danilo-perico/RoboFEI-HT_Drawings/README.md

# RoboFEI-HT_Drawings

Humanoid soccer team from FEI University Center (Brazil).

Repository for mechanical and electronics drawings of our robots and of the robots that have inspired the evolution of our own robots (for example: Darwin-OP).
