danilo-perico/RoboFEI-HT_Drawings/Darwin_OP/Dynamics/mp_arm_lower_l.jpg

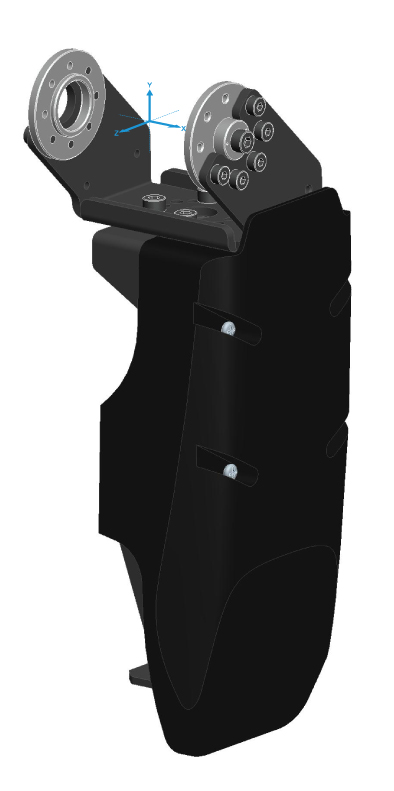
Darwin_OP/Dynamics/mp_arm_lower_l.jpg
