danilo-perico/RoboFEI-HT_Drawings/Darwin_OP/Dynamics/mp_arm_upper_l.jpg

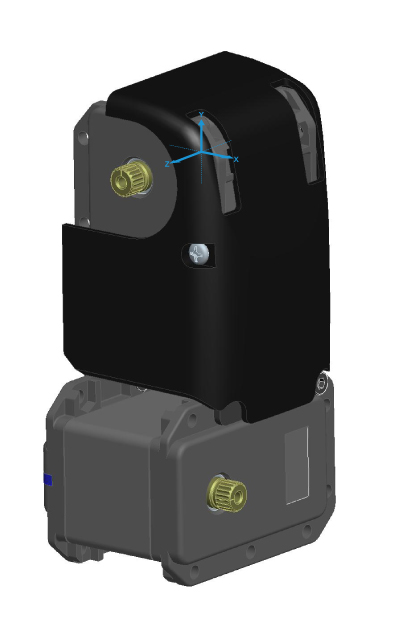
Darwin_OP/Dynamics/mp_arm_upper_l.jpg
