danilo-perico/RoboFEI-HT_Drawings/Darwin_OP/Dynamics/mp_body.jpg

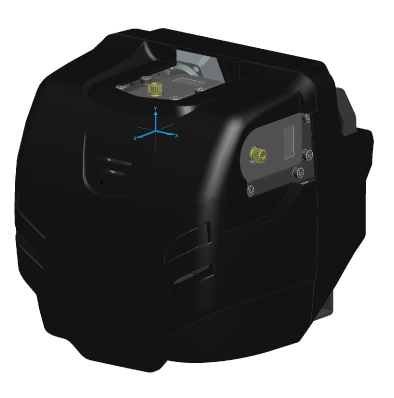
Darwin_OP/Dynamics/mp_body.jpg
