danilo-perico/RoboFEI-HT_Drawings/Darwin_OP/Dynamics/mp_foot_l.jpg

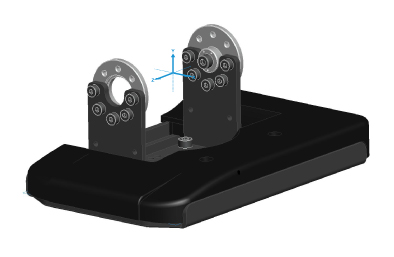
Darwin_OP/Dynamics/mp_foot_l.jpg
