danilo-perico/RoboFEI-HT_Drawings/Darwin_OP/Dynamics/mp_head_1.jpg

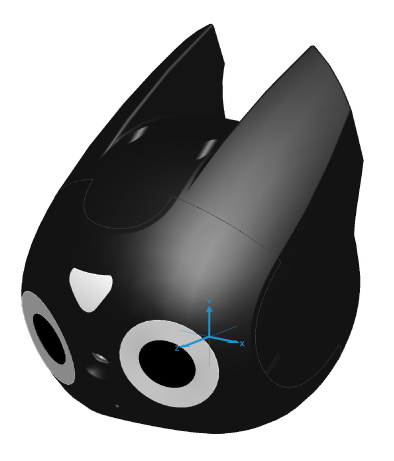
Darwin_OP/Dynamics/mp_head_1.jpg
