danilo-perico/RoboFEI-HT_Drawings/Darwin_OP/Dynamics/mp_head_2.jpg

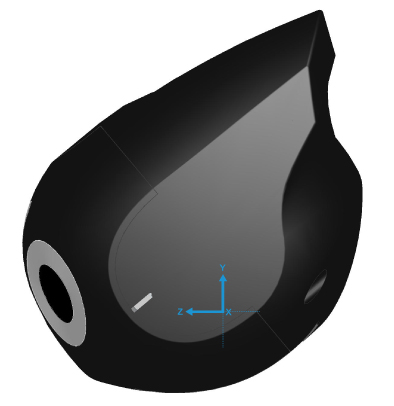
Darwin_OP/Dynamics/mp_head_2.jpg
