danilo-perico/RoboFEI-HT_Drawings/Darwin_OP/Dynamics/mp_neck.jpg

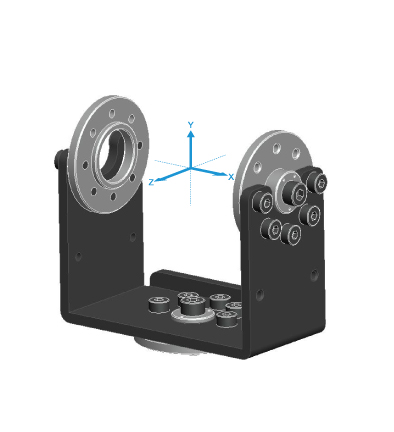
Darwin_OP/Dynamics/mp_neck.jpg
