danilo-perico/RoboFEI-HT_Drawings/Darwin_OP/Dynamics/mp_pelv_y_l.jpg

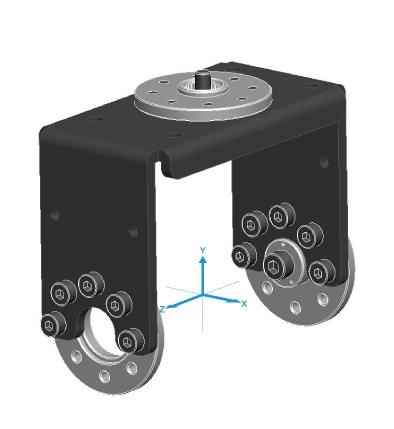
Darwin_OP/Dynamics/mp_pelv_y_l.jpg
