danilo-perico/RoboFEI-HT_Drawings/Milton_robot/Mechanics/DWG CAD/Anexo 1 - Arm0.bmp

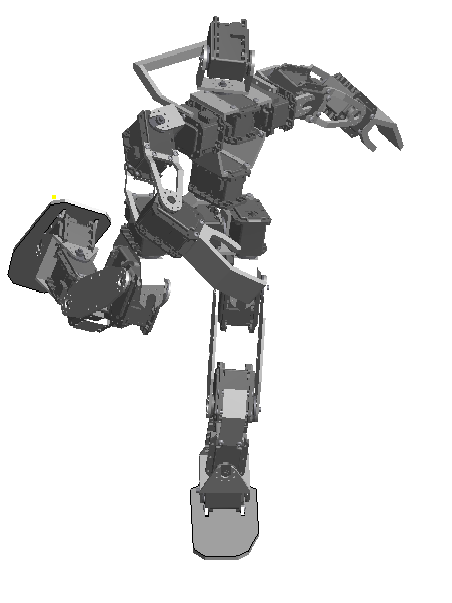
Milton_robot/Mechanics/DWG CAD/Anexo 1 - Arm0.bmp
