danilo-perico/RoboFEI-HT_Drawings/Darwin_OP/Part Files/OP 2D CAD Files/2D STEP/4_PR13_B01_FRM_PCB_MAIN_T.step

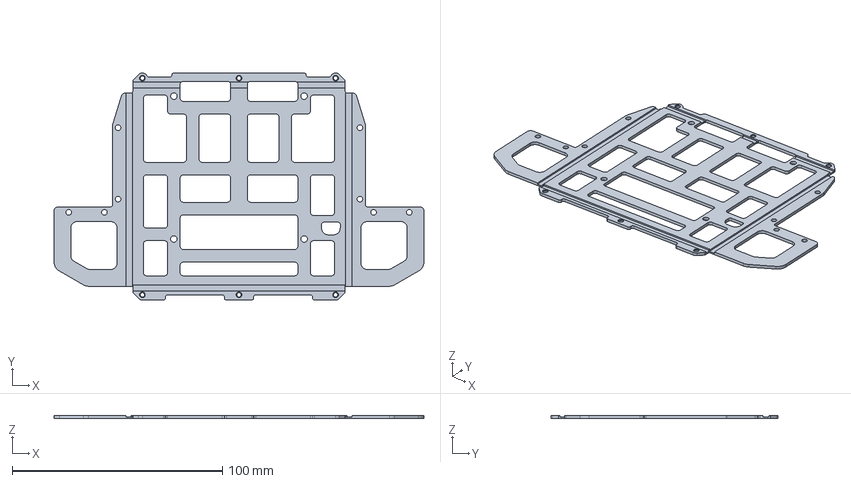
[picture p15: CAD file, 2016-03-04]
Darwin_OP/Part Files/OP 2D CAD Files/2D STEP/4_PR13_B01_FRM_PCB_MAIN_T.step
176.1 x 108.1 x 1.50 mm
