danilo-perico/RoboFEI-HT_Drawings/Darwin_OP/Part Files/OP 3D CAD Files/3D STEP/5_PR13_B01_FRM_PCB_MAIN_B.step

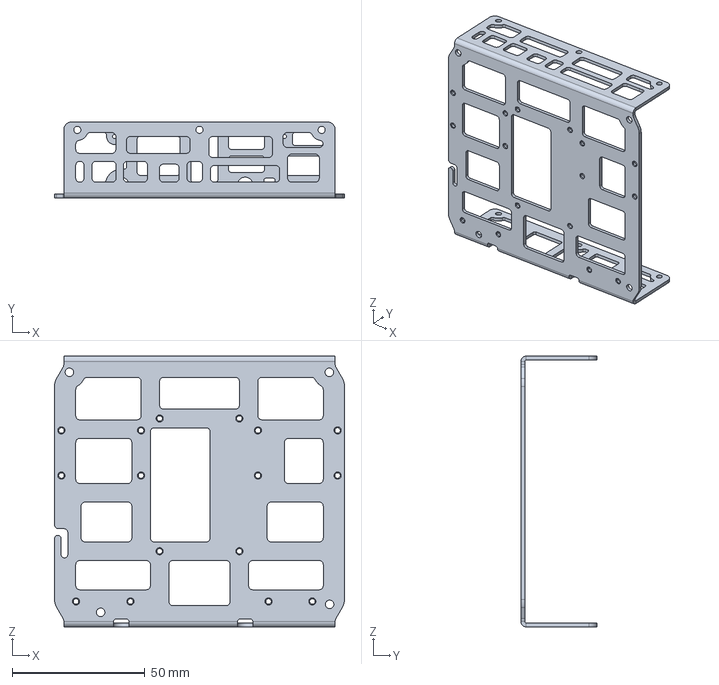
[picture p16: CAD file, 2016-03-04]
Darwin_OP/Part Files/OP 3D CAD Files/3D STEP/5_PR13_B01_FRM_PCB_MAIN_B.step
109.2 x 28.7 x 102.0 mm
