danilo-perico/RoboFEI-HT_Drawings/Darwin_OP/Part Files/OP 2D CAD Files/2D STEP/5_PR13_B01_FRM_PCB_MAIN_B.step

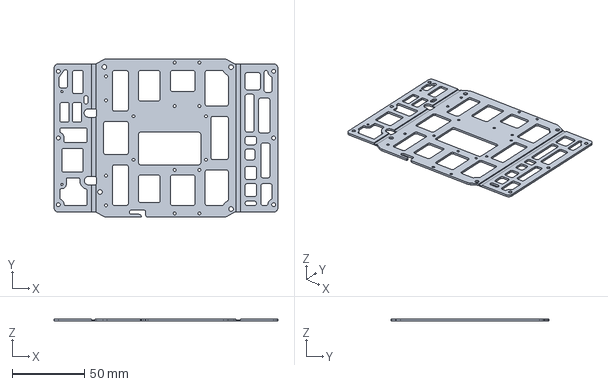
[picture p17: CAD file, 2016-03-04]
Darwin_OP/Part Files/OP 2D CAD Files/2D STEP/5_PR13_B01_FRM_PCB_MAIN_B.step
154.5 x 109.2 x 1.50 mm
