danilo-perico/RoboFEI-HT_Drawings/Darwin_OP/Part Files/OP 3D CAD Files/3D STEP/4_PR13_B01_FRM_PCB_MAIN_T.step

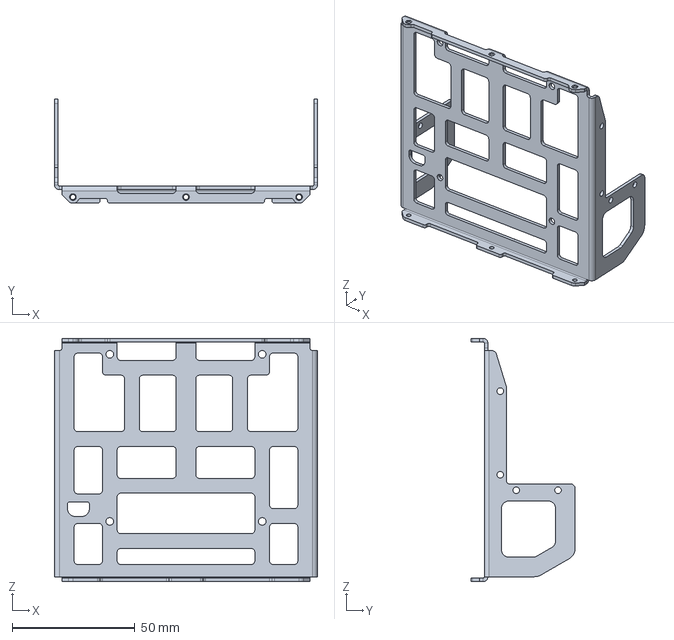
[picture p18: CAD file, 2016-03-04]
Darwin_OP/Part Files/OP 3D CAD Files/3D STEP/4_PR13_B01_FRM_PCB_MAIN_T.step
107.0 x 42.5 x 99.0 mm
