danilo-perico/RoboFEI-HT_Drawings/Darwin_OP/Part Files/OP 3D CAD Files/3D STEP/10_FR07_H102.step

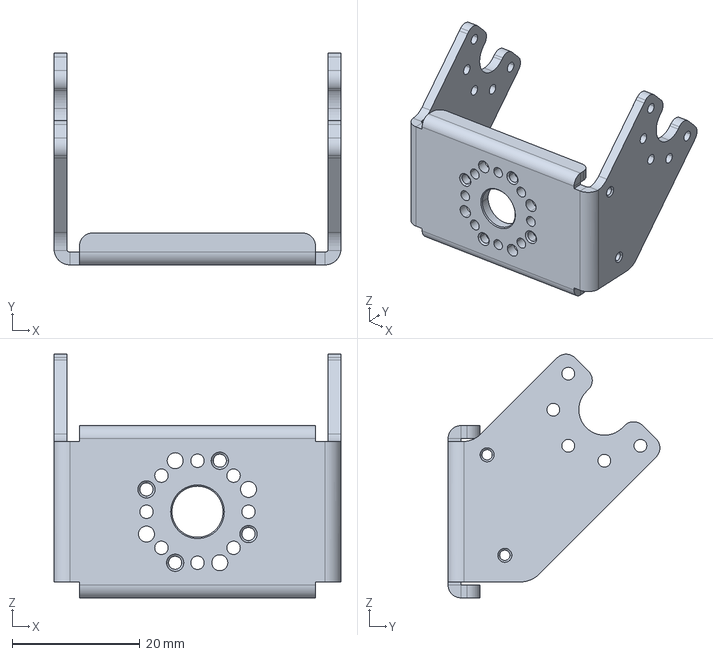
[picture p19: CAD file, 2016-03-04]
Darwin_OP/Part Files/OP 3D CAD Files/3D STEP/10_FR07_H102.step
45.0 x 33.2 x 38.2 mm
