danilo-perico/RoboFEI-HT_Drawings/Darwin_OP/Skin_STP/DARWIN-OP_cvr_eye_l_prt.stp

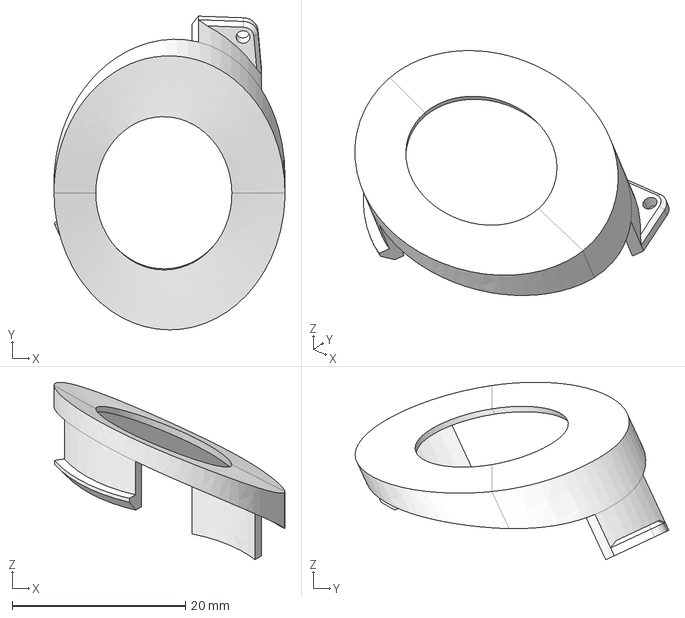
[picture p20: CAD file, 2016-03-04]
Darwin_OP/Skin_STP/DARWIN-OP_cvr_eye_l_prt.stp
26.7 x 36.3 x 20.5 mm
