danilo-perico/RoboFEI-HT_Drawings/FEI/Mesmo Solido/fei.step

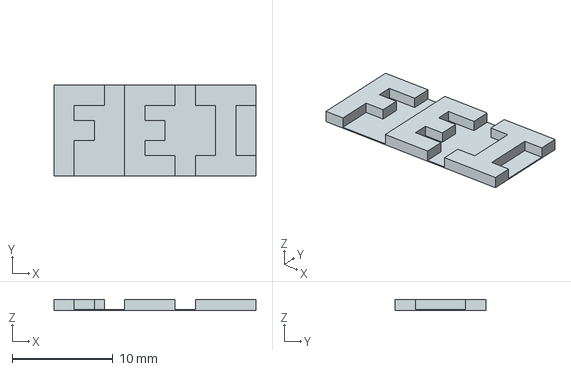
[picture p21: CAD file, 2016-03-04]
FEI/Mesmo Solido/fei.step
20.0 x 9.00 x 1.10 mm
