danilo-perico/RoboFEI-HT_Drawings/FEI/Sem Base/fei.stp

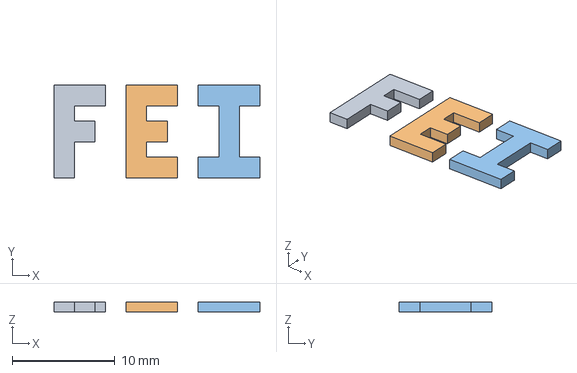
[picture p22: CAD file, 2016-03-04]
FEI/Sem Base/fei.stp
20.0 x 9.00 x 1.00 mm
