danilo-perico/RoboFEI-HT_Drawings/FEI/Solido Diferente/fei.step

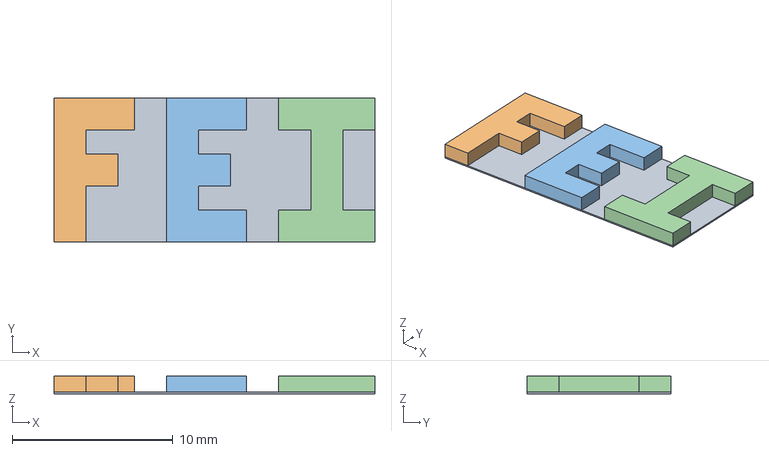
[picture p23: CAD file, 2016-03-04]
FEI/Solido Diferente/fei.step
20.0 x 9.00 x 1.10 mm
