danilo-perico/RoboFEI-HT_Drawings/Darwin_OP/Part Files/OP 2D CAD Files/2D STEP/6_PR13_B_SPACER_PELV.step

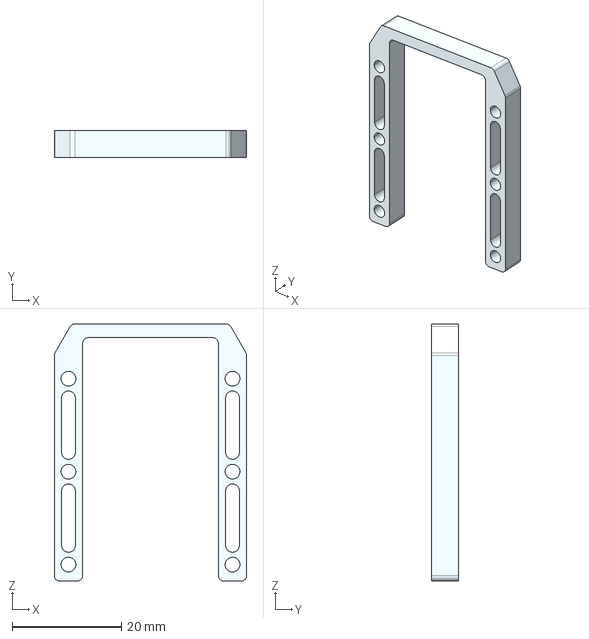
[picture p24: CAD file, 2016-03-04]
Darwin_OP/Part Files/OP 2D CAD Files/2D STEP/6_PR13_B_SPACER_PELV.step
35.2 x 5.00 x 47.0 mm
