danilo-perico/RoboFEI-HT_Drawings/Darwin_OP/Part Files/OP 3D CAD Files/3D STEP/16_FR07_H132.step

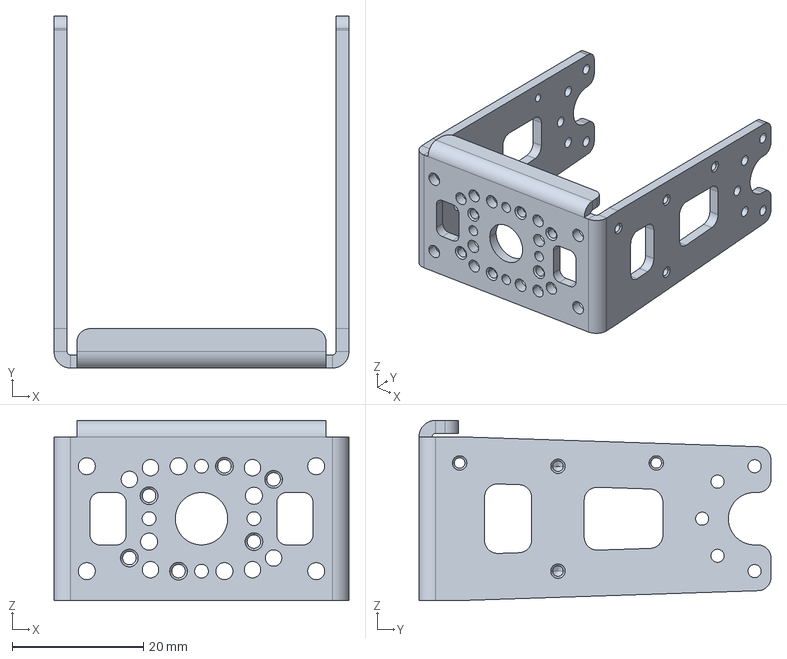
[picture p25: CAD file, 2016-03-04]
Darwin_OP/Part Files/OP 3D CAD Files/3D STEP/16_FR07_H132.step
45.0 x 53.7 x 27.5 mm
