danilo-perico/RoboFEI-HT_Drawings/Darwin_OP/Skin_STP/DARWIN-OP_cvr_foot_l_prt.stp

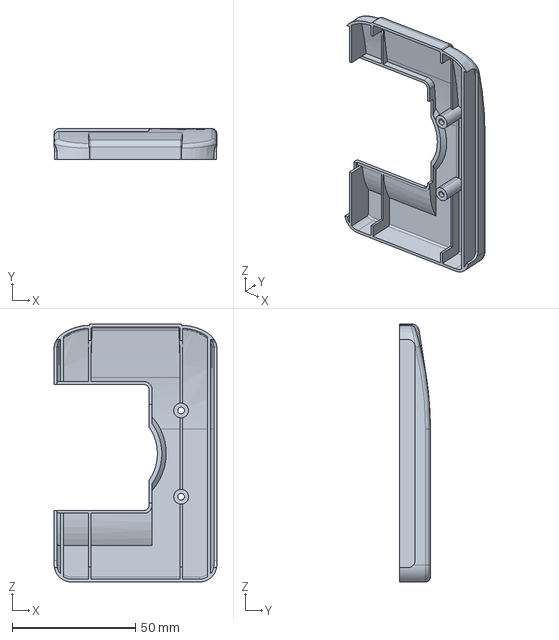
[picture p26: CAD file, 2016-03-04]
Darwin_OP/Skin_STP/DARWIN-OP_cvr_foot_l_prt.stp
66.0 x 12.5 x 104.7 mm
