danilo-perico/RoboFEI-HT_Drawings/Darwin_OP/Part Files/OP 2D CAD Files/2D STEP/9R_PR13_B_BRKT_PELV_R.step

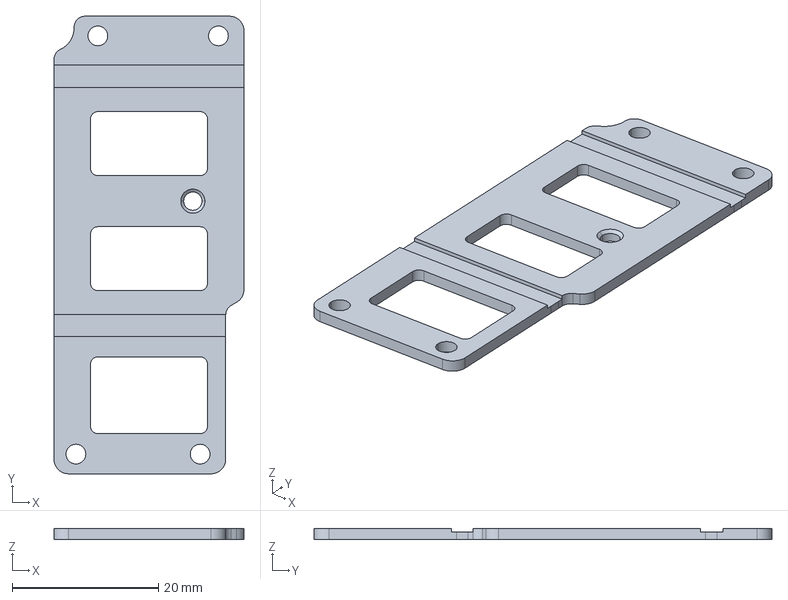
[picture p27: CAD file, 2016-03-04]
Darwin_OP/Part Files/OP 2D CAD Files/2D STEP/9R_PR13_B_BRKT_PELV_R.step
26.0 x 62.6 x 1.50 mm
