danilo-perico/RoboFEI-HT_Drawings/Darwin_OP/Part Files/OP 3D CAD Files/3D STEP/2_FR07_H104.step

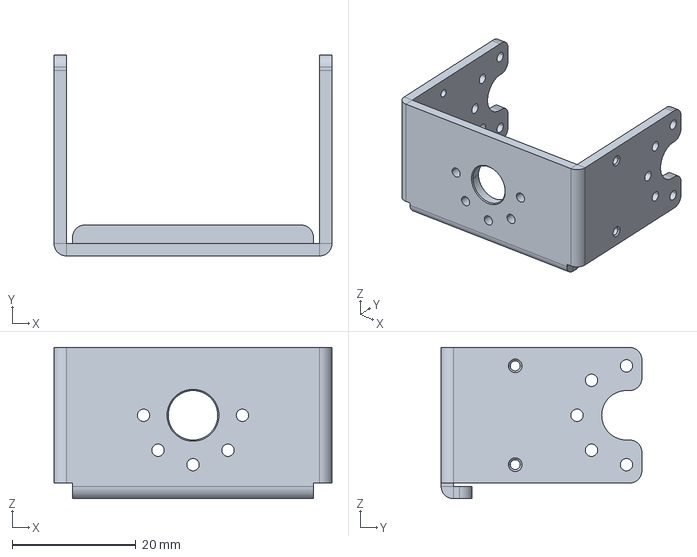
[picture p28: CAD file, 2016-03-04]
Darwin_OP/Part Files/OP 3D CAD Files/3D STEP/2_FR07_H104.step
45.0 x 32.5 x 24.5 mm
