danilo-perico/RoboFEI-HT_Drawings/Darwin_OP/Skin_STP/DARWIN-OP_cvr_head_f_prt.stp

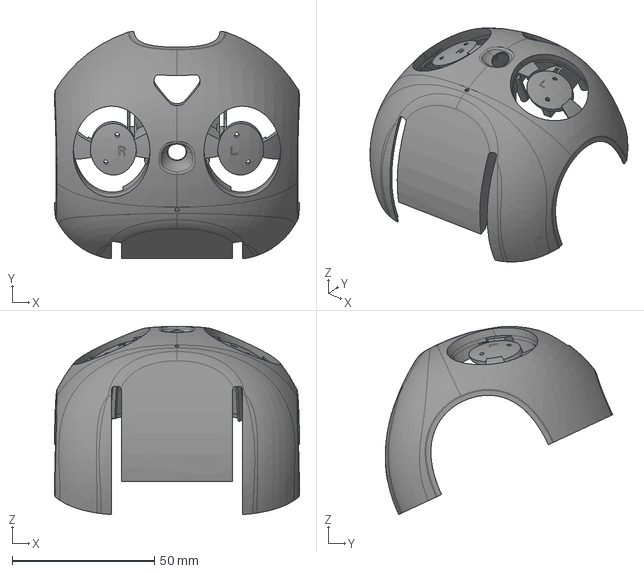
[picture p29: CAD file, 2016-03-04]
Darwin_OP/Skin_STP/DARWIN-OP_cvr_head_f_prt.stp
86.2 x 80.0 x 66.1 mm
