danilo-perico/RoboFEI-HT_Drawings/Darwin_OP/Part Files/OP 2D CAD Files/2D STEP/1_PR13_B01_BRKT_CAM.step

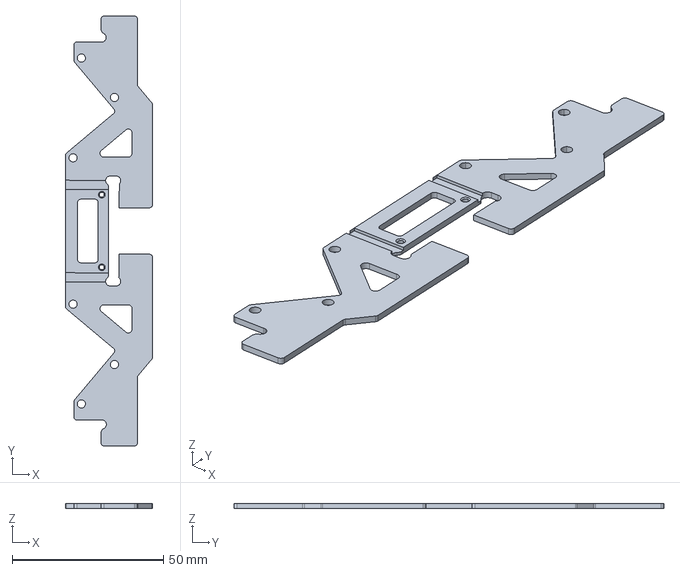
[picture p30: CAD file, 2016-03-04]
Darwin_OP/Part Files/OP 2D CAD Files/2D STEP/1_PR13_B01_BRKT_CAM.step
28.8 x 142.1 x 1.50 mm
