danilo-perico/RoboFEI-HT_Drawings/Darwin_OP/Part Files/OP 3D CAD Files/3D STEP/14_FR07_S101.step

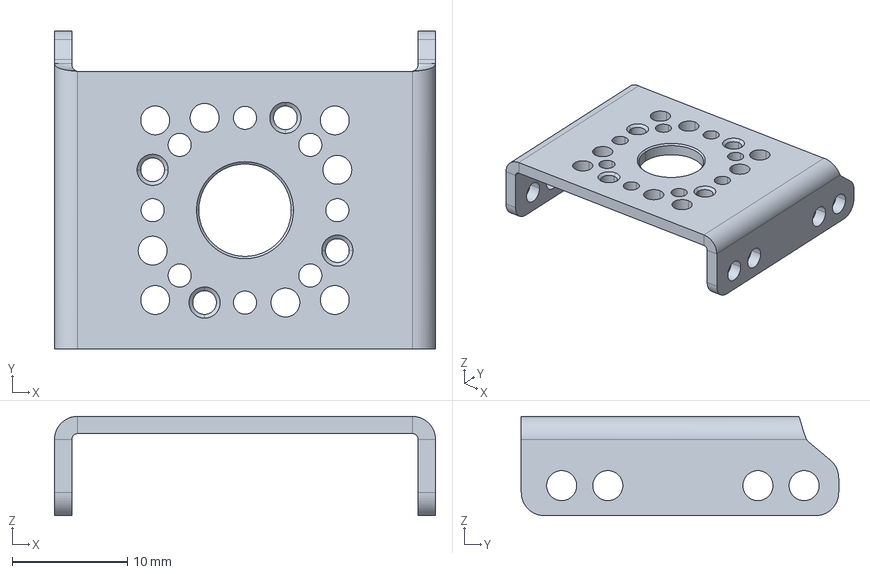
[picture p31: CAD file, 2016-03-04]
Darwin_OP/Part Files/OP 3D CAD Files/3D STEP/14_FR07_S101.step
33.0 x 27.5 x 8.60 mm
