danilo-perico/RoboFEI-HT_Drawings/Darwin_OP/Skin_STP/DARWIN-OP_cvr_body_f_prt.stp

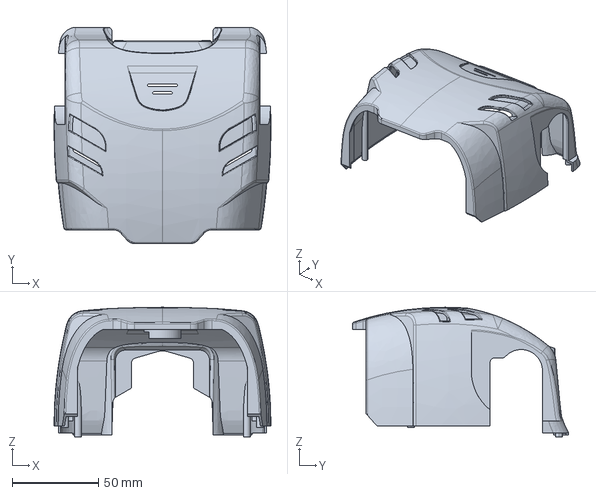
[picture p32: CAD file, 2016-03-04]
Darwin_OP/Skin_STP/DARWIN-OP_cvr_body_f_prt.stp
126.0 x 125.5 x 75.2 mm
