danilo-perico/RoboFEI-HT_Drawings/Darwin_OP/Part Files/OP 2D CAD Files/2D STEP/14_FR07_S101.step

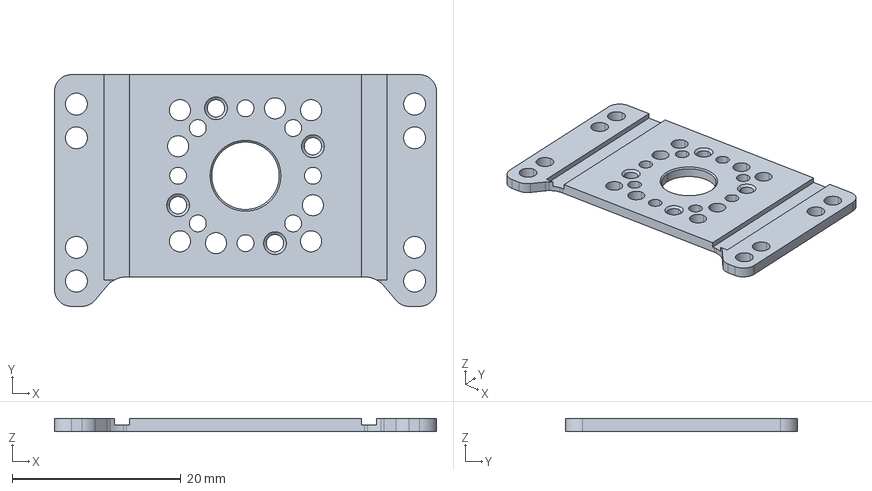
[picture p33: CAD file, 2016-03-04]
Darwin_OP/Part Files/OP 2D CAD Files/2D STEP/14_FR07_S101.step
45.3 x 27.5 x 1.50 mm
