danilo-perico/RoboFEI-HT_Drawings/Darwin_OP/Skin_STP/DARWIN-OP_cvr_pupil_l_prt.stp

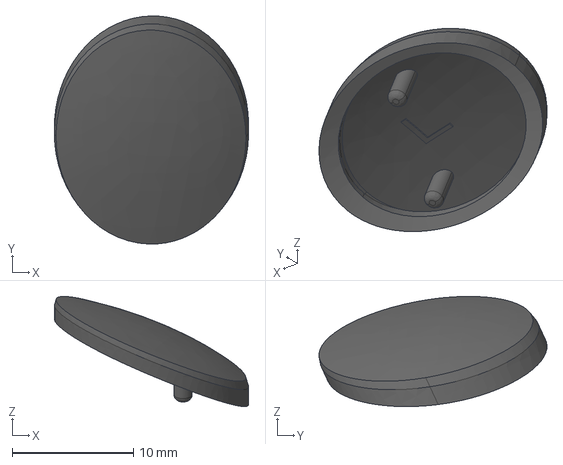
[picture p34: CAD file, 2016-03-04]
Darwin_OP/Skin_STP/DARWIN-OP_cvr_pupil_l_prt.stp
16.0 x 18.8 x 9.08 mm
