danilo-perico/RoboFEI-HT_Drawings/Darwin_OP/Part Files/OP 2D CAD Files/2D STEP/17_FR07_H133.step

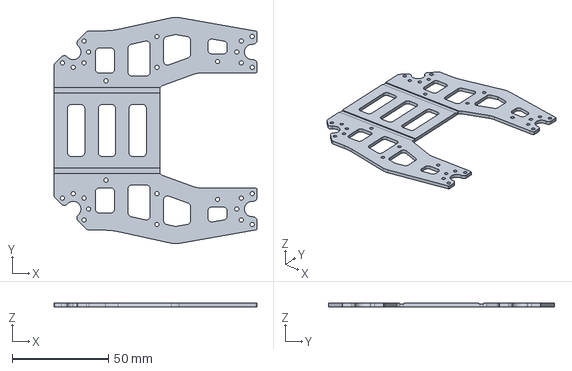
[picture p35: CAD file, 2016-03-04]
Darwin_OP/Part Files/OP 2D CAD Files/2D STEP/17_FR07_H133.step
105.5 x 117.7 x 2.00 mm
