danilo-perico/RoboFEI-HT_Drawings/Darwin_OP/Part Files/OP 3D CAD Files/3D STEP/17_FR07_H133.step

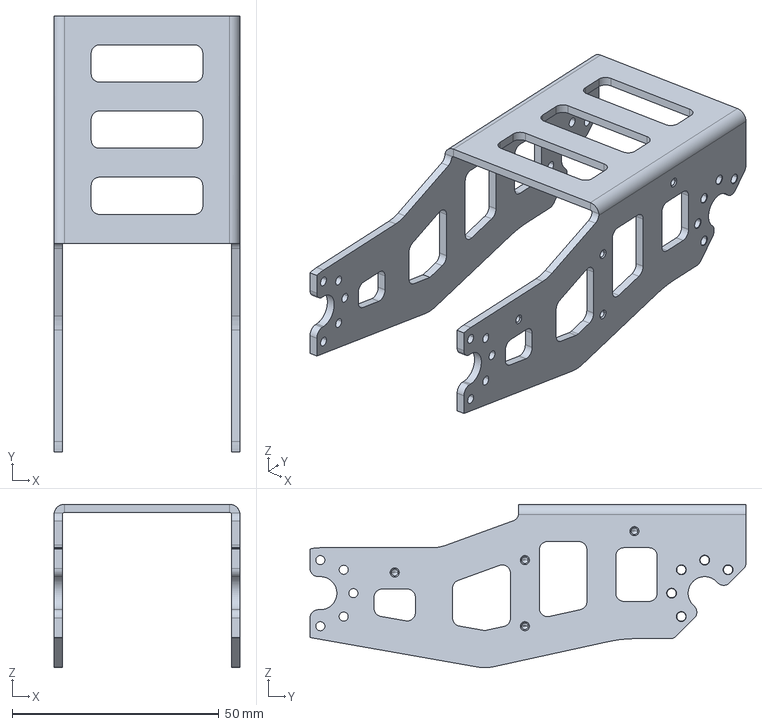
[picture p36: CAD file, 2016-03-04]
Darwin_OP/Part Files/OP 3D CAD Files/3D STEP/17_FR07_H133.step
45.0 x 105.5 x 39.5 mm
