danilo-perico/RoboFEI-HT_Drawings/Darwin_OP/Skin_STP/DARWIN-OP_cvr_arm_u_prt.stp

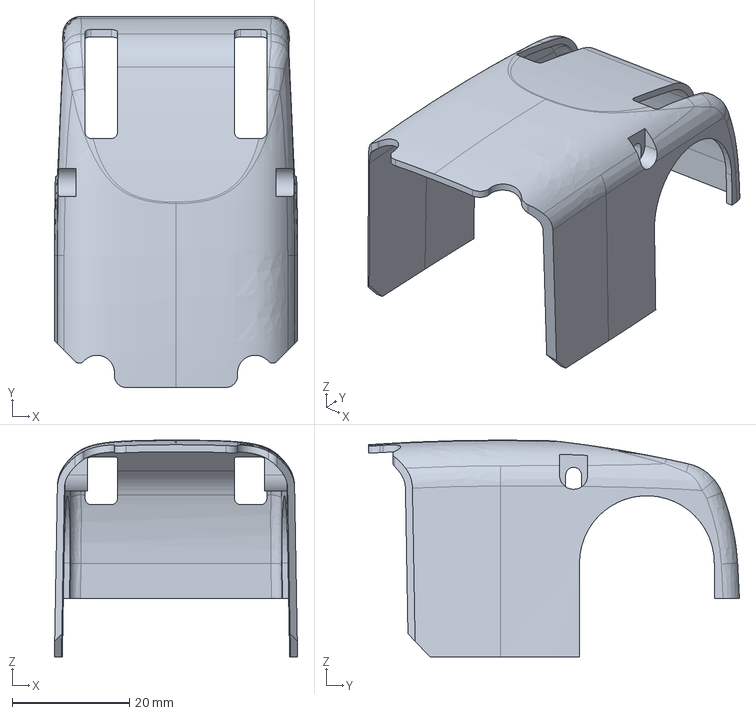
[picture p37: CAD file, 2016-03-04]
Darwin_OP/Skin_STP/DARWIN-OP_cvr_arm_u_prt.stp
41.5 x 63.3 x 37.0 mm
