danilo-perico/RoboFEI-HT_Drawings/Darwin_OP/Part Files/OP 2D CAD Files/2D STEP/7_FR07_E130.step

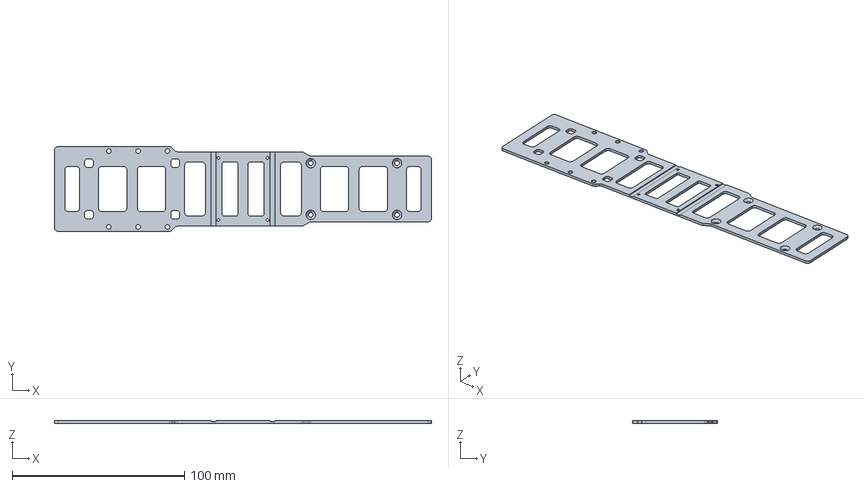
[picture p38: CAD file, 2016-03-04]
Darwin_OP/Part Files/OP 2D CAD Files/2D STEP/7_FR07_E130.step
218.6 x 49.2 x 1.50 mm
