danilo-perico/RoboFEI-HT_Drawings/Darwin_OP/Part Files/OP 3D CAD Files/3D STEP/7_FR07_E130.step

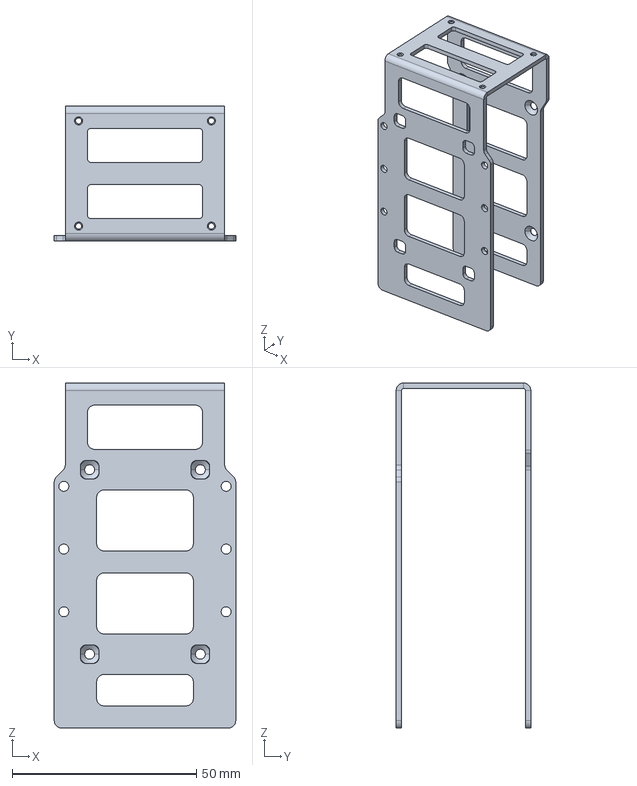
[picture p39: CAD file, 2016-03-04]
Darwin_OP/Part Files/OP 3D CAD Files/3D STEP/7_FR07_E130.step
49.2 x 36.5 x 93.5 mm
