danilo-perico/RoboFEI-HT_Drawings/Darwin_OP/Skin_STP/DARWIN-OP_cvr_body_b_prt.stp

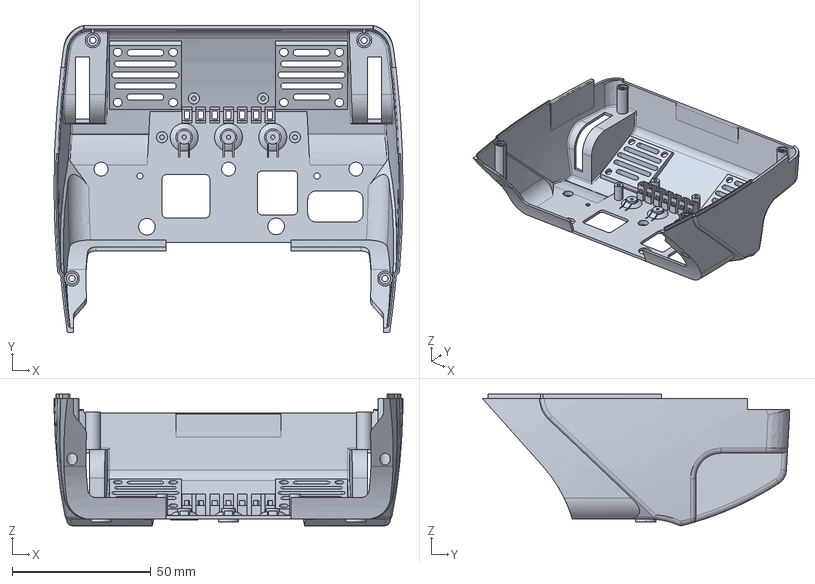
[picture p40: CAD file, 2016-03-04]
Darwin_OP/Skin_STP/DARWIN-OP_cvr_body_b_prt.stp
126.0 x 111.0 x 47.5 mm
