danilo-perico/RoboFEI-HT_Drawings/Darwin_OP/Part Files/OP 2D CAD Files/2D STEP/3_FR07_X101.step

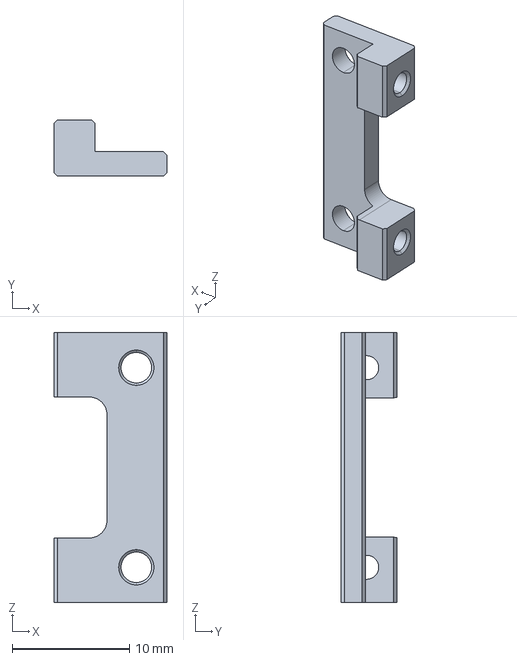
[picture p41: CAD file, 2016-03-04]
Darwin_OP/Part Files/OP 2D CAD Files/2D STEP/3_FR07_X101.step
9.60 x 4.80 x 23.0 mm
