danilo-perico/RoboFEI-HT_Drawings/Darwin_OP/Part Files/OP 3D CAD Files/3D STEP/12_FR07_E180.step

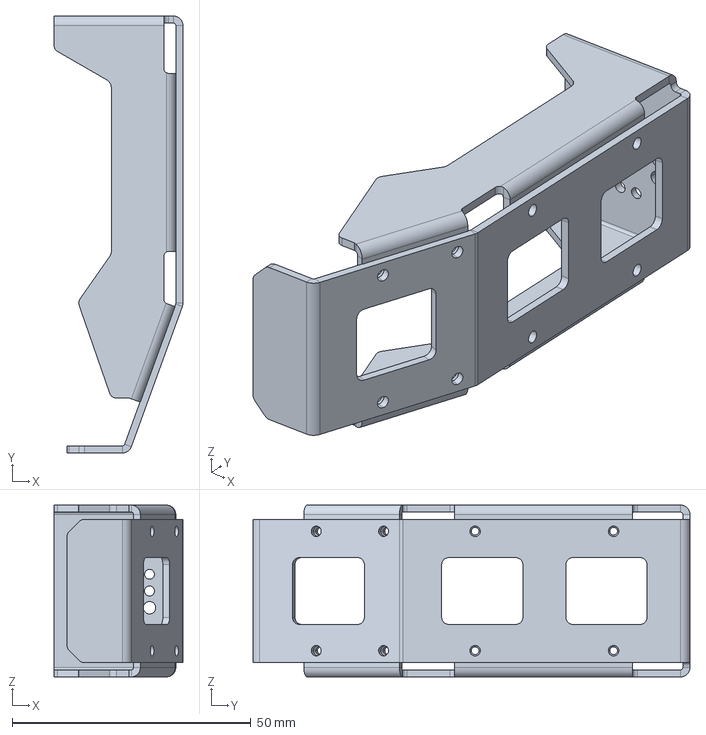
[picture p42: CAD file, 2016-03-04]
Darwin_OP/Part Files/OP 3D CAD Files/3D STEP/12_FR07_E180.step
27.0 x 91.5 x 36.0 mm
