danilo-perico/RoboFEI-HT_Drawings/Darwin_OP/Part Files/OP 2D CAD Files/2D STEP/18_FR07_E160.step

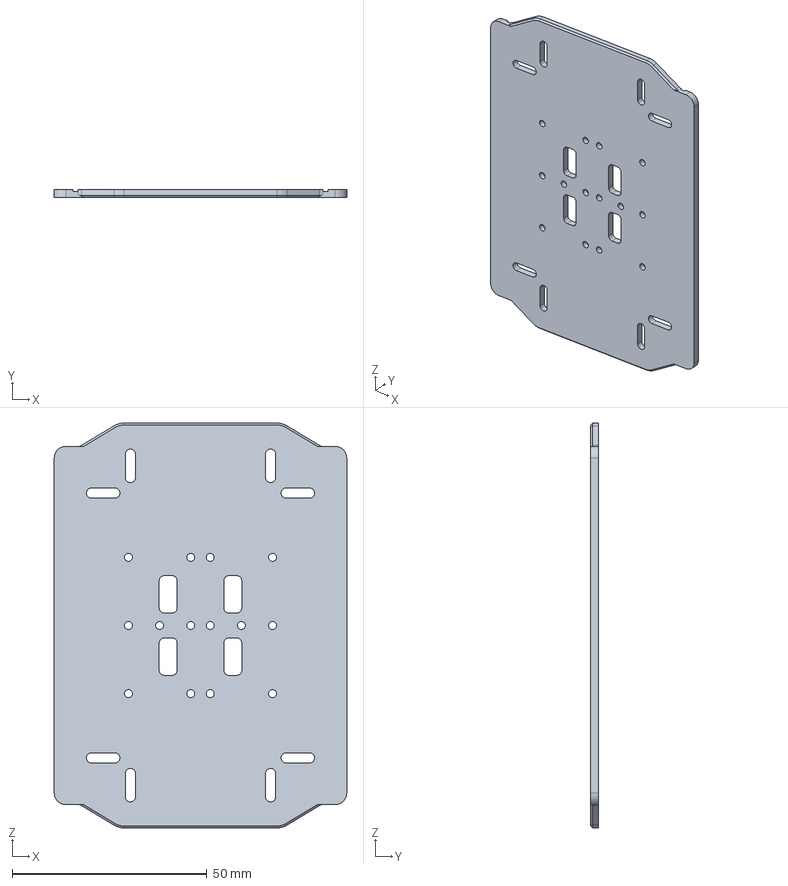
[picture p43: CAD file, 2016-03-04]
Darwin_OP/Part Files/OP 2D CAD Files/2D STEP/18_FR07_E160.step
75.1 x 2.00 x 104.0 mm
