danilo-perico/RoboFEI-HT_Drawings/Darwin_OP/Part Files/OP 3D CAD Files/3D STEP/1_PR13_B01_BRKT_CAM.step

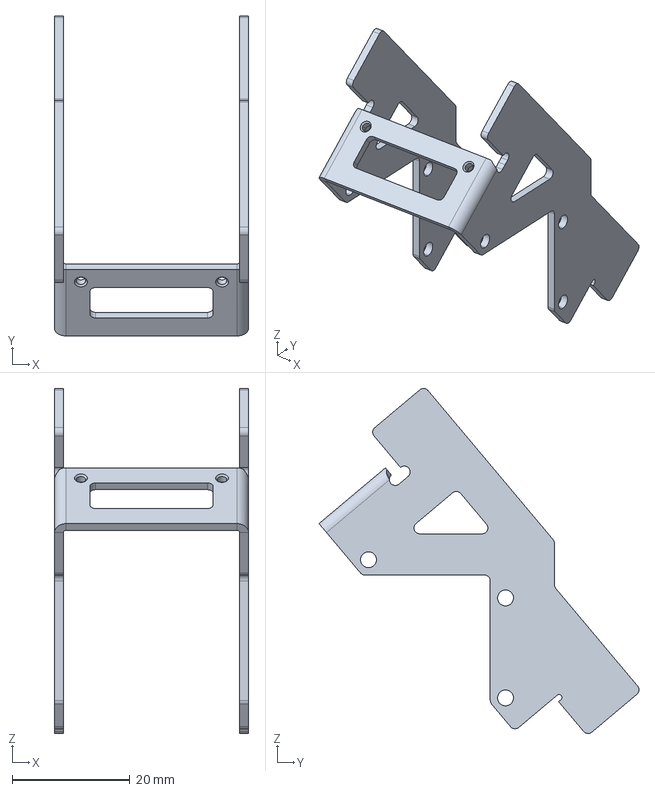
[picture p44: CAD file, 2016-03-04]
Darwin_OP/Part Files/OP 3D CAD Files/3D STEP/1_PR13_B01_BRKT_CAM.step
33.0 x 54.4 x 58.7 mm
