danilo-perico/RoboFEI-HT_Drawings/Darwin_OP/Skin_STP/DARWIN-OP_cvr_thigh_prt.stp

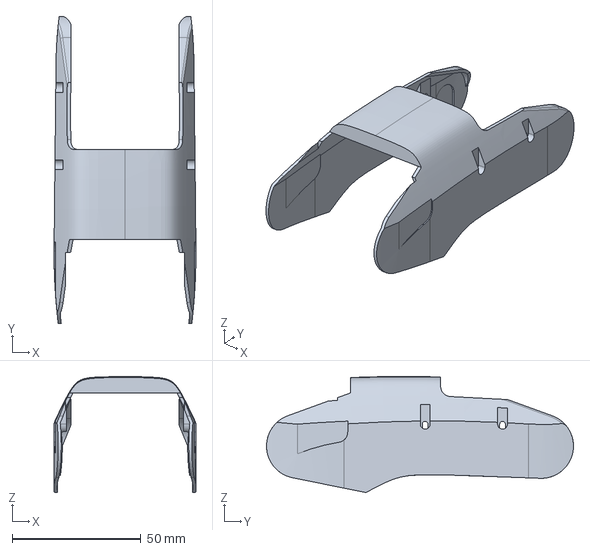
[picture p45: CAD file, 2016-03-04]
Darwin_OP/Skin_STP/DARWIN-OP_cvr_thigh_prt.stp
55.0 x 119.0 x 45.0 mm
