danilo-perico/RoboFEI-HT_Drawings/Darwin_OP/Part Files/OP 2D CAD Files/2D STEP/11_FR07_SC101.step

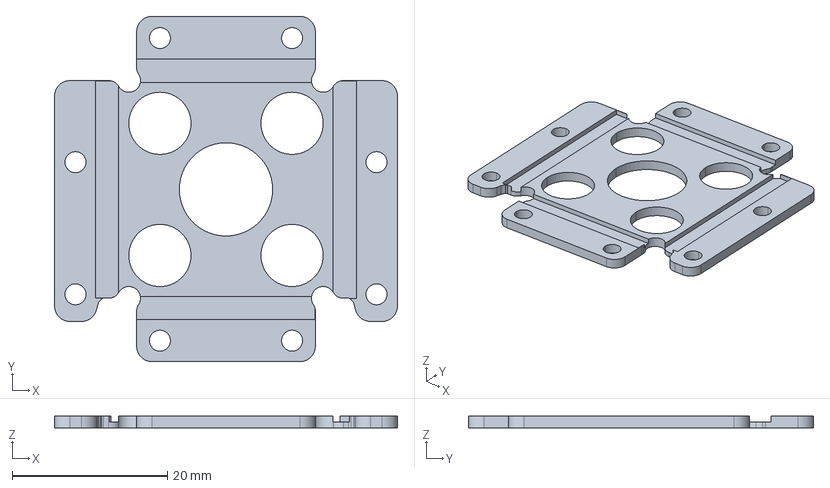
[picture p46: CAD file, 2016-03-04]
Darwin_OP/Part Files/OP 2D CAD Files/2D STEP/11_FR07_SC101.step
44.1 x 44.4 x 1.50 mm
