danilo-perico/RoboFEI-HT_Drawings/Darwin_OP/Part Files/OP 3D CAD Files/3D STEP/8_PR13_FRM_CVR_BAT.step

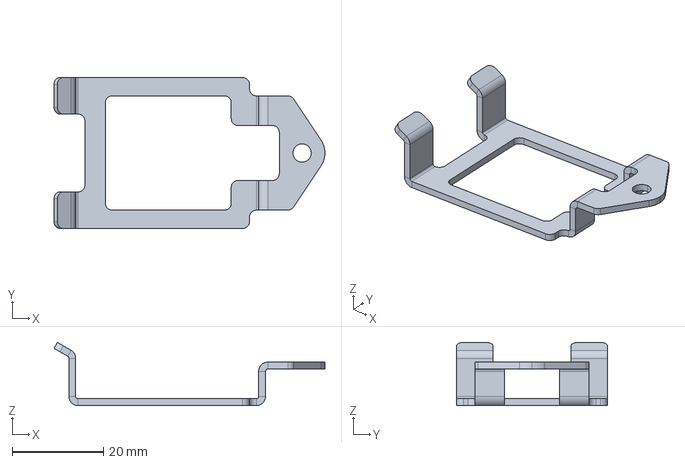
[picture p47: CAD file, 2016-03-04]
Darwin_OP/Part Files/OP 3D CAD Files/3D STEP/8_PR13_FRM_CVR_BAT.step
59.2 x 33.0 x 13.8 mm
