danilo-perico/RoboFEI-HT_Drawings/Darwin_OP/Skin_STP/DARWIN-OP_cvr_head_b_prt.stp

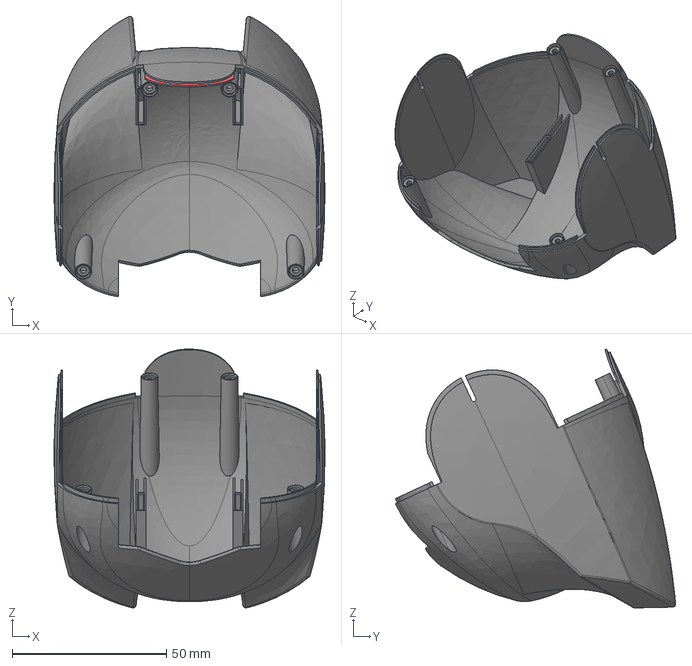
[picture p48: CAD file, 2016-03-04]
Darwin_OP/Skin_STP/DARWIN-OP_cvr_head_b_prt.stp
88.0 x 91.0 x 84.1 mm
