danilo-perico/RoboFEI-HT_Drawings/Darwin_OP/Part Files/OP 2D CAD Files/2D STEP/2_FR07_H104.step

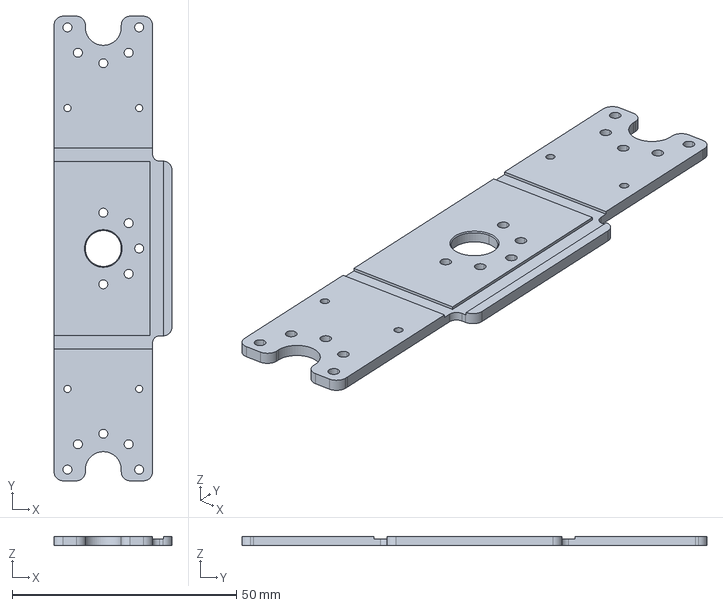
[picture p49: CAD file, 2016-03-04]
Darwin_OP/Part Files/OP 2D CAD Files/2D STEP/2_FR07_H104.step
26.3 x 103.6 x 2.00 mm
