danilo-perico/RoboFEI-HT_Drawings/Darwin_OP/Skin_STP/DARWIN-OP_cvr_arm_l_prt.stp

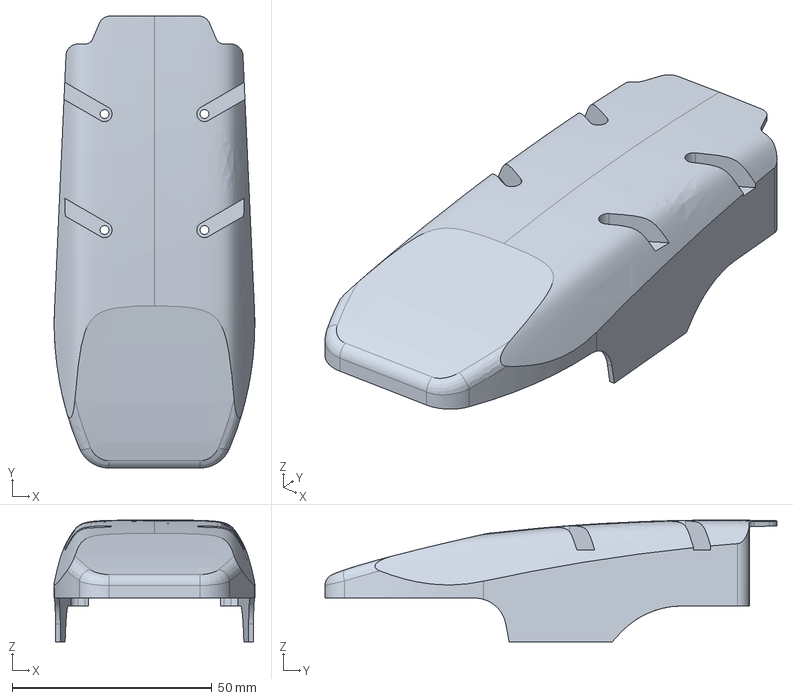
[picture p50: CAD file, 2016-03-04]
Darwin_OP/Skin_STP/DARWIN-OP_cvr_arm_l_prt.stp
50.2 x 113.0 x 30.5 mm
