danilo-perico/RoboFEI-HT_Drawings/Darwin_OP/Part Files/OP 2D CAD Files/2D STEP/12_FR07_E180.step

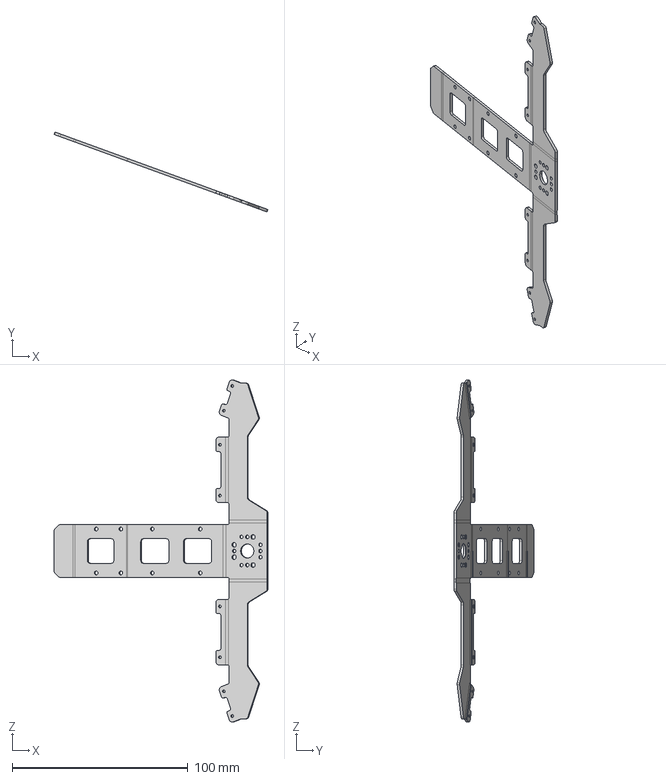
[picture p51: CAD file, 2016-03-04]
Darwin_OP/Part Files/OP 2D CAD Files/2D STEP/12_FR07_E180.step
121.8 x 45.6 x 194.8 mm
