danilo-perico/RoboFEI-HT_Drawings/Darwin_OP/Part Files/OP 3D CAD Files/3D STEP/9R_PR13_B_BRKT_PELV_R.step

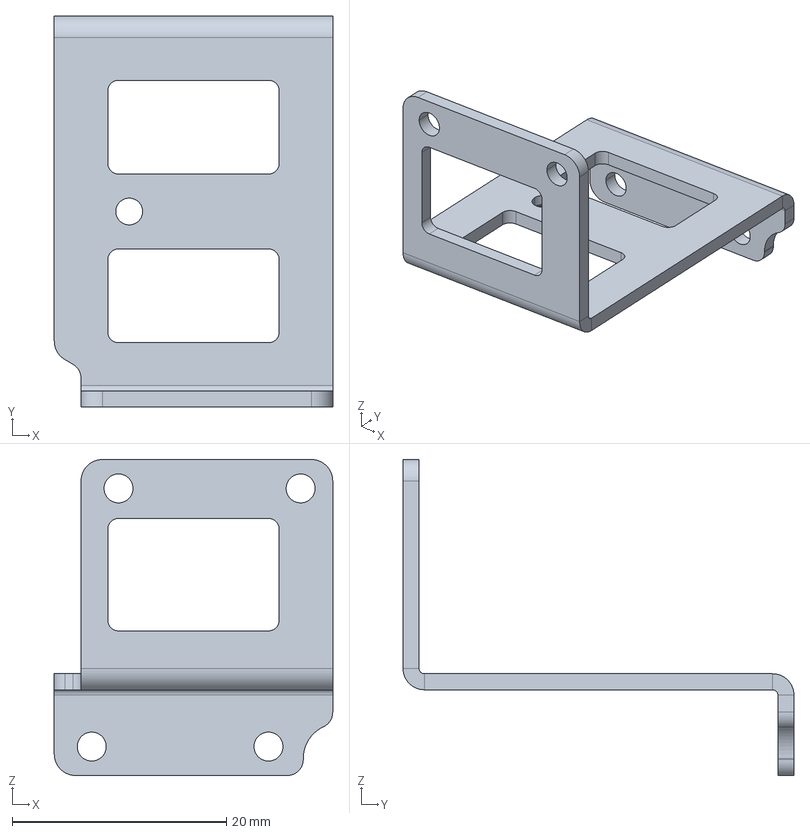
[picture p52: CAD file, 2016-03-04]
Darwin_OP/Part Files/OP 3D CAD Files/3D STEP/9R_PR13_B_BRKT_PELV_R.step
26.0 x 36.5 x 29.5 mm
