danilo-perico/RoboFEI-HT_Drawings/Darwin_OP/Part Files/OP 2D CAD Files/2D STEP/8_PR13_B_FRM_CVR_BAT.step

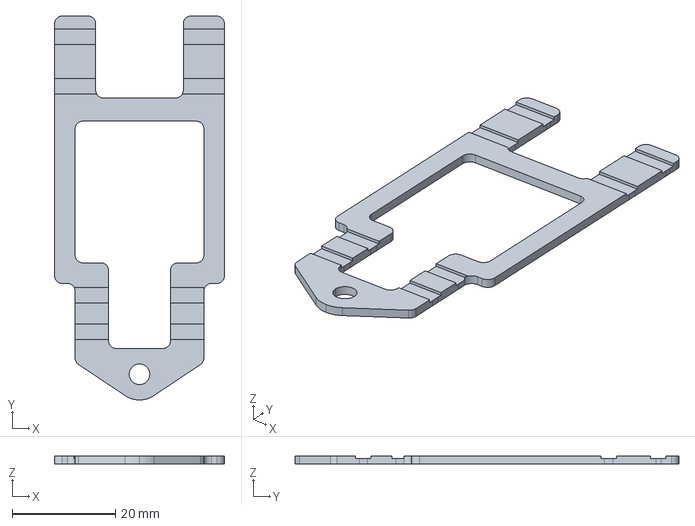
[picture p53: CAD file, 2016-03-04]
Darwin_OP/Part Files/OP 2D CAD Files/2D STEP/8_PR13_B_FRM_CVR_BAT.step
33.0 x 74.5 x 1.50 mm
