danilo-perico/RoboFEI-HT_Drawings/Darwin_OP/Part Files/OP 3D CAD Files/3D STEP/18_FR07_E160.step

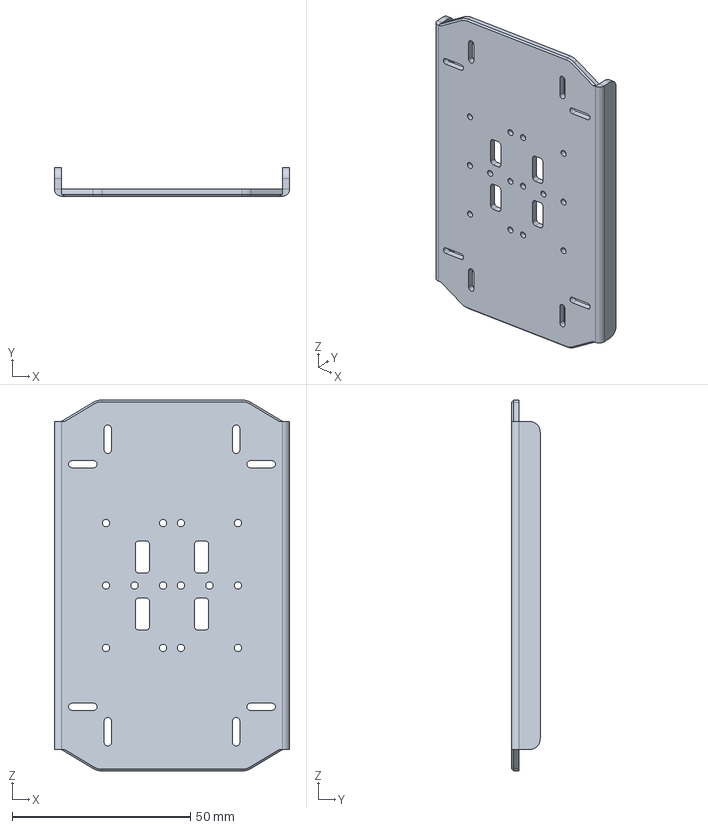
[picture p54: CAD file, 2016-03-04]
Darwin_OP/Part Files/OP 3D CAD Files/3D STEP/18_FR07_E160.step
66.0 x 8.00 x 104.0 mm
