danilo-perico/RoboFEI-HT_Drawings/Darwin_OP/Skin_STP/DARWIN-OP_win_led_prt.stp

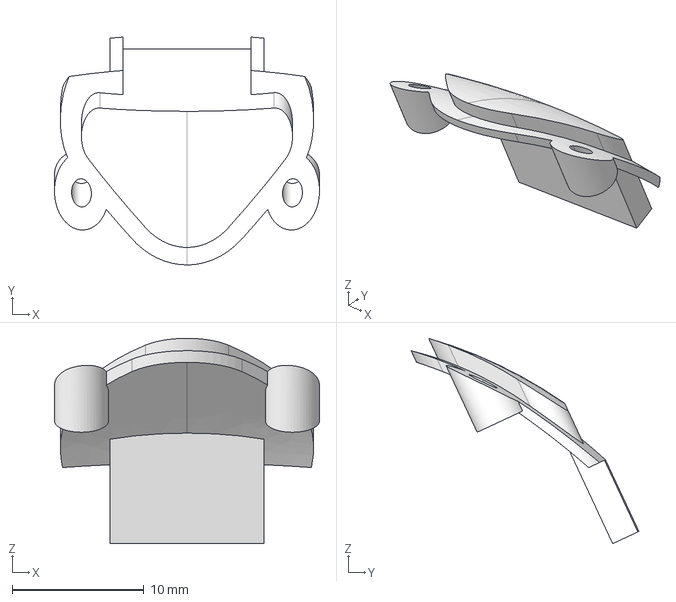
[picture p55: CAD file, 2016-03-04]
Darwin_OP/Skin_STP/DARWIN-OP_win_led_prt.stp
20.1 x 17.3 x 15.6 mm
