danilo-perico/RoboFEI-HT_Drawings/Darwin_OP/Part Files/OP 2D CAD Files/2D STEP/15_FR07_X102.step

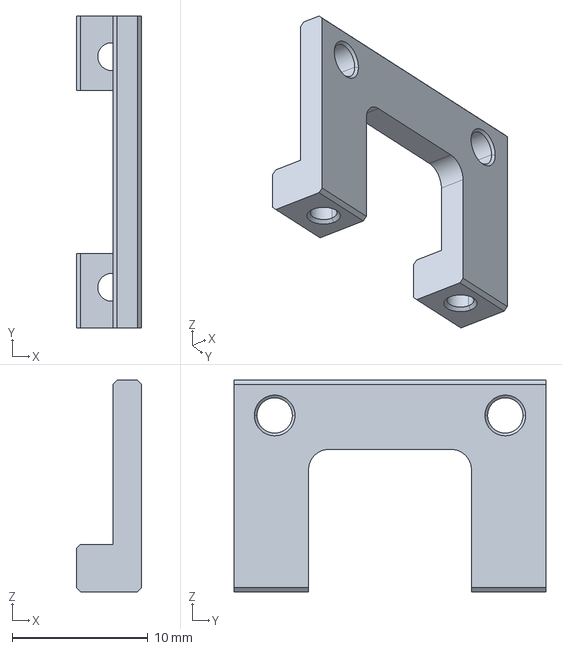
[picture p56: CAD file, 2016-03-04]
Darwin_OP/Part Files/OP 2D CAD Files/2D STEP/15_FR07_X102.step
4.80 x 23.0 x 15.6 mm
