danilo-perico/RoboFEI-HT_Drawings/Darwin_OP/Skin_STP/DARWIN-OP_cvr_tibia_prt.stp

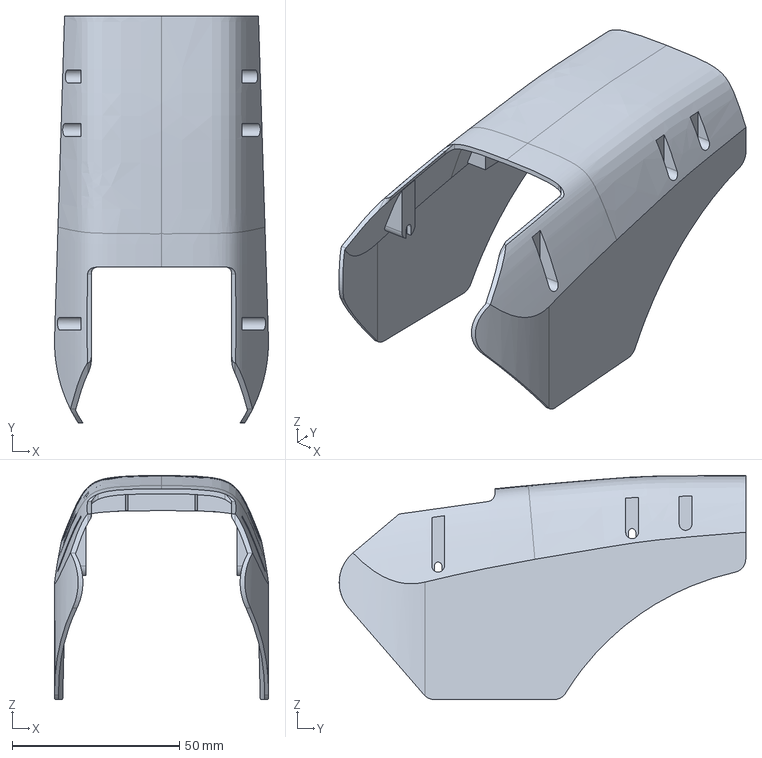
[picture p57: CAD file, 2016-03-04]
Darwin_OP/Skin_STP/DARWIN-OP_cvr_tibia_prt.stp
64.0 x 121.6 x 67.0 mm
