danilo-perico/RoboFEI-HT_Drawings/Darwin_OP/Part Files/OP 3D CAD Files/3D STEP/11_FR07_SC101.step

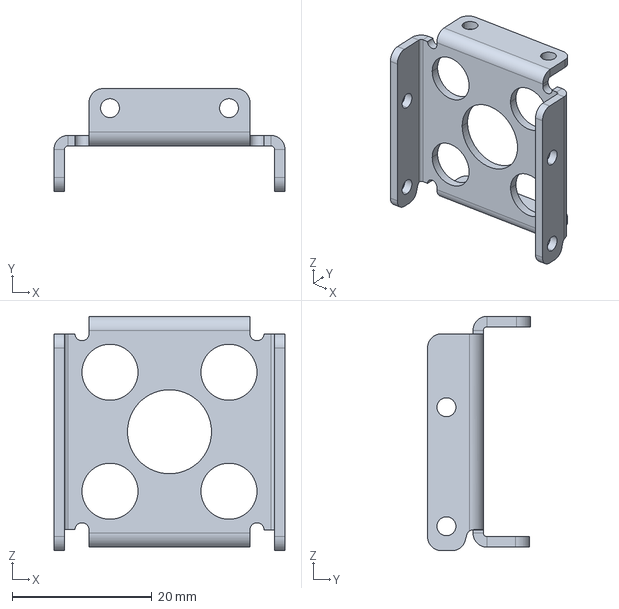
[picture p58: CAD file, 2016-03-04]
Darwin_OP/Part Files/OP 3D CAD Files/3D STEP/11_FR07_SC101.step
33.0 x 14.7 x 33.5 mm
