danilo-perico/RoboFEI-HT_Drawings/Darwin_OP/Part Files/OP 2D CAD Files/2D STEP/10_FR07_H102.step

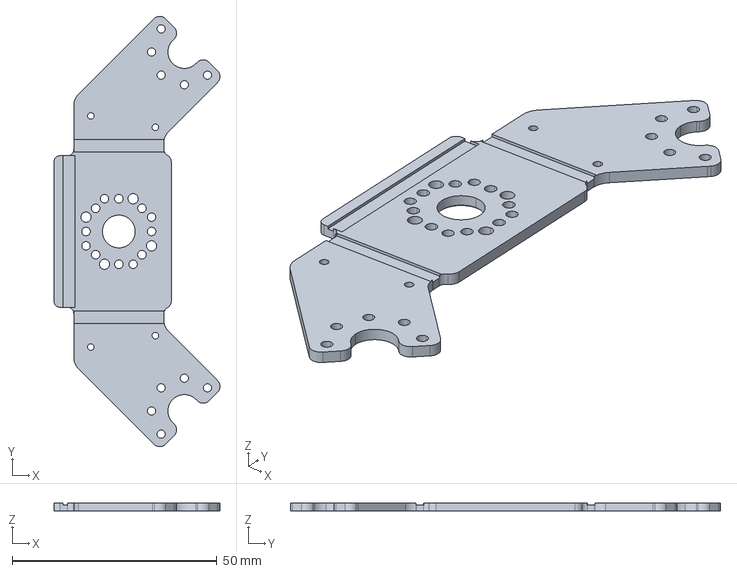
[picture p59: CAD file, 2016-03-04]
Darwin_OP/Part Files/OP 2D CAD Files/2D STEP/10_FR07_H102.step
40.5 x 105.1 x 2.00 mm
