danilo-perico/RoboFEI-HT_Drawings/Darwin_OP/Part Files/OP 3D CAD Files/3D STEP/13_FR07_H120.step

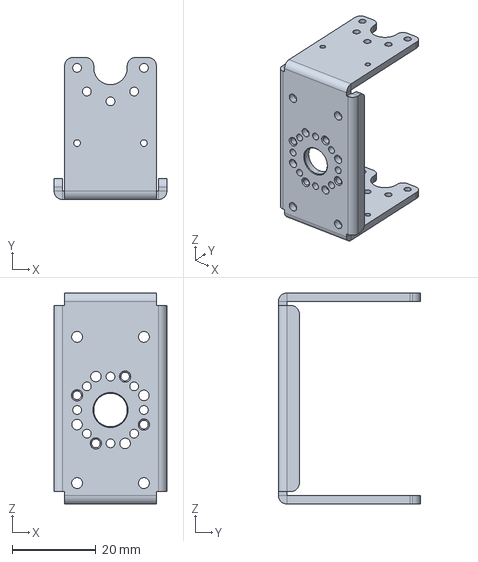
[picture p60: CAD file, 2016-03-04]
Darwin_OP/Part Files/OP 3D CAD Files/3D STEP/13_FR07_H120.step
27.0 x 34.0 x 50.5 mm
