danilo-perico/RoboFEI-HT_Drawings/Darwin_OP/Part Files/OP 2D CAD Files/2D STEP/13_FR07_H120.step

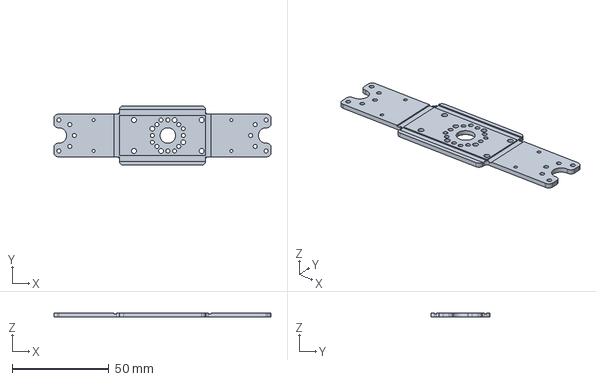
[picture p61: CAD file, 2016-03-04]
Darwin_OP/Part Files/OP 2D CAD Files/2D STEP/13_FR07_H120.step
112.1 x 30.6 x 2.00 mm
