danilo-perico/RoboFEI-HT_Drawings/Darwin_OP/Part Files/OP 2D CAD Files/2D STEP/16_FR07_H132.step

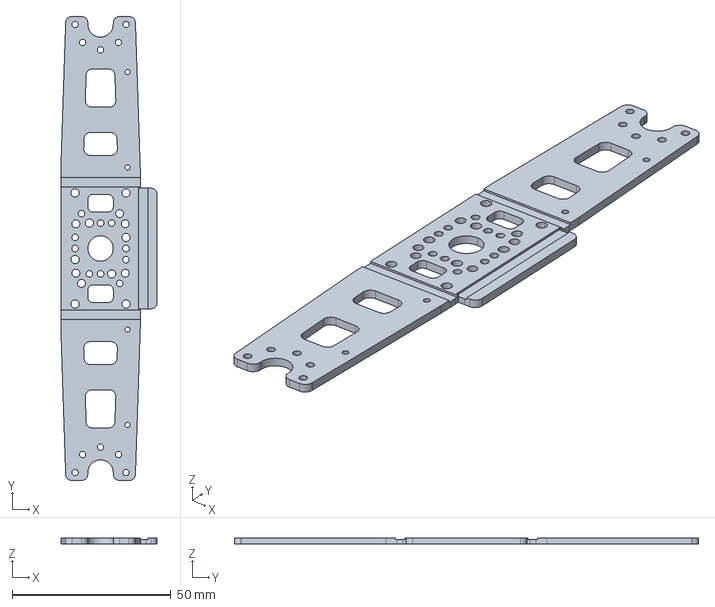
[picture p62: CAD file, 2016-03-04]
Darwin_OP/Part Files/OP 2D CAD Files/2D STEP/16_FR07_H132.step
30.3 x 146.0 x 2.00 mm
