danilo-perico/RoboFEI-HT_Drawings/Darwin_OP/Part Files/OP 3D CAD Files/3D STEP/9L_PR13_B_BRKT_PELV_L.step

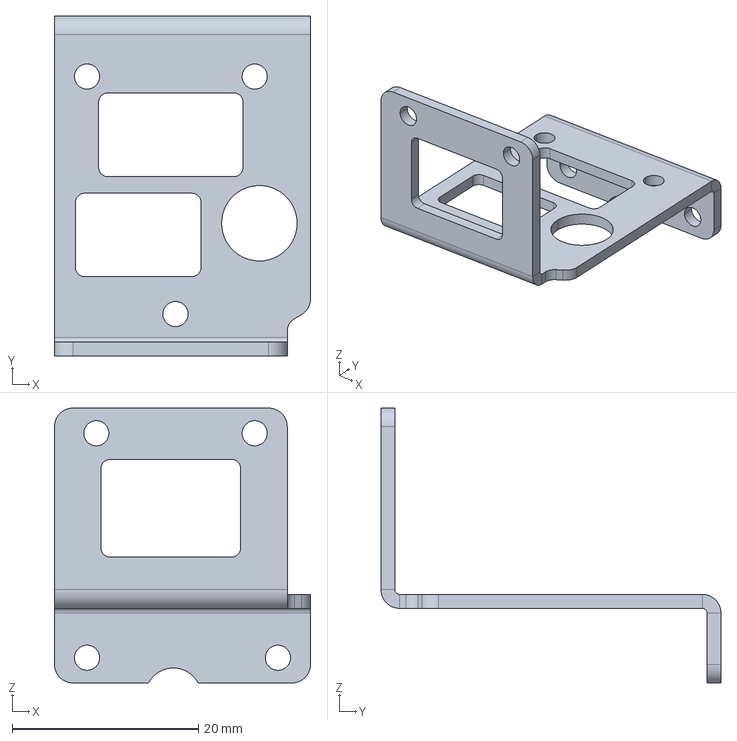
[picture p63: CAD file, 2016-03-04]
Darwin_OP/Part Files/OP 3D CAD Files/3D STEP/9L_PR13_B_BRKT_PELV_L.step
27.5 x 36.5 x 29.5 mm
