danilo-perico/RoboFEI-HT_Drawings/Darwin_OP/Part Files/OP 2D CAD Files/2D STEP/9L_PR13_B_BRKT_PELV_L.step

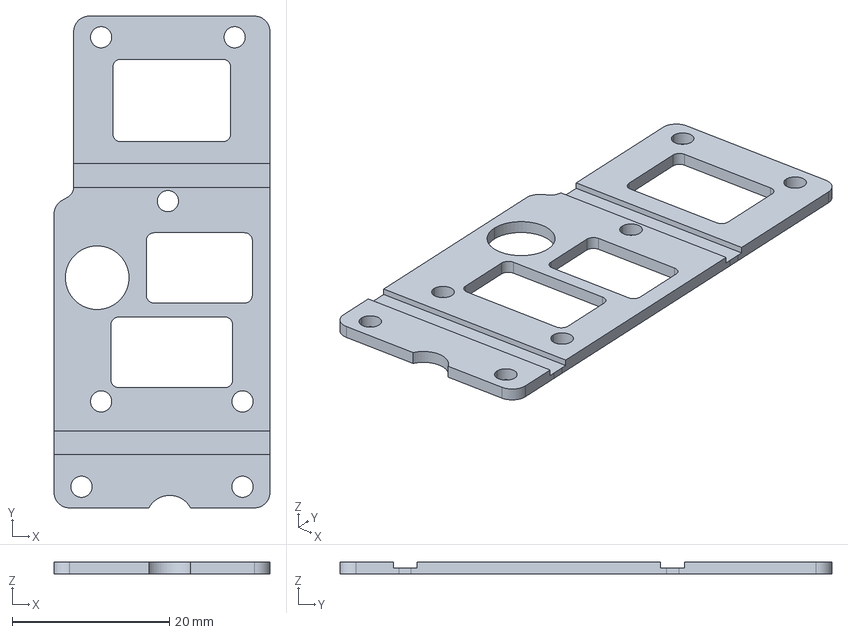
[picture p64: CAD file, 2016-03-04]
Darwin_OP/Part Files/OP 2D CAD Files/2D STEP/9L_PR13_B_BRKT_PELV_L.step
27.5 x 62.6 x 1.50 mm
