danilo-perico/RoboFEI-HT_Drawings/(list of files, cad)

Other CAD files:
Milton_robot/Mechanics/DWG CAD/Anexo 18 - Alça.dwg
Milton_robot/Mechanics/DWG Inventor/Anexo 15 - Trapezium.dwg
FEI/Sem Base/fei.prt.step
Milton_robot/Mechanics/DWG CAD/Anexo 15 - Trapezium.dwg
Milton_robot/Mechanics/DWG Inventor/Anexo 10 - Right Hand.dwg
Milton_robot/Mechanics/DWG CAD/Anexo 9 - Left Hand.dwg
Milton_robot/Mechanics/DWG Inventor/Template.dwg
Milton_robot/Mechanics/DWG CAD/Anexo 3 - Groin.dwg
Milton_robot/Mechanics/DWG Inventor/Humanoid.dwg
Milton_robot/Mechanics/DWG CAD/Anexo 17 - Waistline.dwg
Milton_robot/Mechanics/DWG Inventor/Anexo 12 - Pelvis.dwg
Milton_robot/Mechanics/DWG CAD/Anexo 11 - Neck.dwg
Milton_robot/Mechanics/DWG Inventor/Humanóide Vitruviano.dwg
Milton_robot/Mechanics/DWG CAD/Anexo 8 - Right Foot.dwg
Milton_robot/Mechanics/DWG Inventor/Anexo 9 - Left Hand.dwg
Darwin_OP/Skin_STP/DARWIN-OP_cvr_foot_r_prt.stp
Milton_robot/Mechanics/DWG CAD/Anexo 5 - Knee back.dwg
Milton_robot/Mechanics/DWG Inventor/RX-28 Horn.DWG
Milton_robot/Mechanics/DWG CAD/Anexo 1 - Arm.dwg
Milton_robot/Mechanics/DWG Inventor/Anexo 6 - Knee Front.dwg
Milton_robot/Mechanics/DWG CAD/Anexo 14 - Thigh.dwg
Milton_robot/Mechanics/DWG Inventor/Anexo 2 - Ankle.dwg
Darwin_OP/Part Files/OP 3D CAD Files/3D STEP/6_PR13_B_SPACER_PELV.step
Milton_robot/Mechanics/DWG CAD/Anexo 16 - Trunk.dwg
Milton_robot/Mechanics/DWG Inventor/Anexo 8 - Right Foot.dwg
Darwin_OP/Skin_STP/DARWIN-OP_cvr_eye_r_prt.stp
Milton_robot/Mechanics/DWG CAD/Anexo 13 - Shoulder.dwg
Milton_robot/Mechanics/DWG Inventor/Anexo 5 - Knee back.dwg
Milton_robot/Mechanics/DWG CAD/Anexo 6 - Knee Front.dwg
Milton_robot/Mechanics/DWG Inventor/Anexo 11 - Neck.dwg
Darwin_OP/Part Files/OP 3D CAD Files/3D STEP/15_FR07_X102.step
Milton_robot/Mechanics/DWG CAD/Anexo 7 -Left Foot.dwg
Milton_robot/Mechanics/DWG Inventor/Anexo 17 - Waistline.dwg
Darwin_OP/Skin_STP/DARWIN-OP_cvr_pupil_r_prt.stp
Milton_robot/Mechanics/DWG CAD/Anexo 10 - Right Hand.dwg
Milton_robot/Mechanics/DWG Inventor/Humanóide.dwg
Milton_robot/Mechanics/DWG CAD/Anexo 2 - Ankle.dwg
Milton_robot/Mechanics/DWG Inventor/Anexo 4 - Hips.dwg
Darwin_OP/Part Files/OP 3D CAD Files/3D STEP/3_FR07_X101.step
Milton_robot/Mechanics/DWG CAD/Anexo 12 - Pelvis.dwg
Milton_robot/Mechanics/DWG Inventor/Anexo 7 -Left Foot.dwg
Milton_robot/Mechanics/DWG CAD/Anexo 4 - Hips.dwg
Milton_robot/Mechanics/DWG Inventor/Anexo 14 - Thigh.dwg
Milton_robot/Mechanics/DWG Inventor/Anexo 1 - Arm.dwg
Milton_robot/Mechanics/DWG Inventor/Anexo 16 - Trunk.dwg
Milton_robot/Mechanics/DWG Inventor/Anexo 3 - Groin.dwg
Milton_robot/Mechanics/DWG Inventor/Anexo 18 - Alça.dwg
Milton_robot/Mechanics/DWG Inventor/Anexo 13 - Shoulder.dwg
Darwin_OP/Part Files/OP 2D CAD Files/2D IGS/10_FR07_H102.igs
Darwin_OP/Part Files/OP 2D CAD Files/2D IGS/11_FR07_SC101.igs
Darwin_OP/Part Files/OP 2D CAD Files/2D IGS/12_FR07_E180.igs
Darwin_OP/Part Files/OP 2D CAD Files/2D IGS/13_FR07_H120.igs
Darwin_OP/Part Files/OP 2D CAD Files/2D IGS/14_FR07_S101.igs
Darwin_OP/Part Files/OP 2D CAD Files/2D IGS/15_FR07_X102.igs
Darwin_OP/Part Files/OP 2D CAD Files/2D IGS/16_FR07_H132.igs
Darwin_OP/Part Files/OP 2D CAD Files/2D IGS/17_FR07_H133.igs
Darwin_OP/Part Files/OP 2D CAD Files/2D IGS/18_FR07_E160.igs
Darwin_OP/Part Files/OP 2D CAD Files/2D IGS/1_PR13_B01_BRKT_CAM.igs
Darwin_OP/Part Files/OP 2D CAD Files/2D IGS/2_FR07_H104.igs
Darwin_OP/Part Files/OP 2D CAD Files/2D IGS/3_FR07_X101.igs
Darwin_OP/Part Files/OP 2D CAD Files/2D IGS/4_PR13_B01_FRM_PCB_MAIN_T.igs
Darwin_OP/Part Files/OP 2D CAD Files/2D IGS/5_PR13_B01_FRM_PCB_MAIN_B.igs
Darwin_OP/Part Files/OP 2D CAD Files/2D IGS/6_PR13_B_SPACER_PELV.igs
Darwin_OP/Part Files/OP 2D CAD Files/2D IGS/7_FR07_E130.igs
Darwin_OP/Part Files/OP 2D CAD Files/2D IGS/8_PR13_B_FRM_CVR_BAT.igs
Darwin_OP/Part Files/OP 2D CAD Files/2D IGS/9L_PR13_B_BRKT_PELV_L.igs
Darwin_OP/Part Files/OP 2D CAD Files/2D IGS/9R_PR13_B_BRKT_PELV_R.igs
Darwin_OP/Part Files/OP 2D CAD Files/2D PRT/10_FR07_H102.prt
Darwin_OP/Part Files/OP 2D CAD Files/2D PRT/11_FR07_SC101.prt
Darwin_OP/Part Files/OP 2D CAD Files/2D PRT/12_FR07_E180.prt
Darwin_OP/Part Files/OP 2D CAD Files/2D PRT/13_FR07_H120.prt
Darwin_OP/Part Files/OP 2D CAD Files/2D PRT/14_FR07_S101.prt
Darwin_OP/Part Files/OP 2D CAD Files/2D PRT/15_FR07_X102.prt
Darwin_OP/Part Files/OP 2D CAD Files/2D PRT/16_FR07_H132.prt
Darwin_OP/Part Files/OP 2D CAD Files/2D PRT/17_FR07_H133.prt
Darwin_OP/Part Files/OP 2D CAD Files/2D PRT/18_FR07_E160.prt
Darwin_OP/Part Files/OP 2D CAD Files/2D PRT/1_PR13_B01_BRKT_CAM.prt
Darwin_OP/Part Files/OP 2D CAD Files/2D PRT/2_FR07_H104.prt
Darwin_OP/Part Files/OP 2D CAD Files/2D PRT/3_FR07_X101.prt
Darwin_OP/Part Files/OP 2D CAD Files/2D PRT/4_PR13_B01_FRM_PCB_MAIN_T.prt
Darwin_OP/Part Files/OP 2D CAD Files/2D PRT/5_PR13_B01_FRM_PCB_MAIN_B.prt
Darwin_OP/Part Files/OP 2D CAD Files/2D PRT/6_PR13_B_SPACER_PELV.prt
Darwin_OP/Part Files/OP 2D CAD Files/2D PRT/7_FR07_E130.prt
Darwin_OP/Part Files/OP 2D CAD Files/2D PRT/8_PR13_B_FRM_CVR_BAT.prt
Darwin_OP/Part Files/OP 2D CAD Files/2D PRT/9L_PR13_B_BRKT_PELV_L.prt
Darwin_OP/Part Files/OP 2D CAD Files/2D PRT/9R_PR13_B_BRKT_PELV_R.prt
Darwin_OP/Part Files/OP 3D CAD Files/3D IGS/10_FR07_H102.igs
Darwin_OP/Part Files/OP 3D CAD Files/3D IGS/11_FR07_SC101.igs
Darwin_OP/Part Files/OP 3D CAD Files/3D IGS/12_FR07_E180.igs
Darwin_OP/Part Files/OP 3D CAD Files/3D IGS/13_FR07_H120.igs
Darwin_OP/Part Files/OP 3D CAD Files/3D IGS/14_FR07_S101.igs
Darwin_OP/Part Files/OP 3D CAD Files/3D IGS/15_FR07_X102.igs
Darwin_OP/Part Files/OP 3D CAD Files/3D IGS/16_FR07_H132.igs
Darwin_OP/Part Files/OP 3D CAD Files/3D IGS/17_FR07_H133.igs
Darwin_OP/Part Files/OP 3D CAD Files/3D IGS/18_FR07_E160.igs
Darwin_OP/Part Files/OP 3D CAD Files/3D IGS/1_PR13_B01_BRKT_CAM.igs
Darwin_OP/Part Files/OP 3D CAD Files/3D IGS/2_FR07_H104.igs
Darwin_OP/Part Files/OP 3D CAD Files/3D IGS/3_FR07_X101.igs
Darwin_OP/Part Files/OP 3D CAD Files/3D IGS/4_PR13_B01_FRM_PCB_MAIN_T.igs
Darwin_OP/Part Files/OP 3D CAD Files/3D IGS/5_PR13_B01_FRM_PCB_MAIN_B.igs
Darwin_OP/Part Files/OP 3D CAD Files/3D IGS/6_PR13_B_SPACER_PELV.igs
Darwin_OP/Part Files/OP 3D CAD Files/3D IGS/7_FR07_E130.igs
Darwin_OP/Part Files/OP 3D CAD Files/3D IGS/8_PR13_FRM_CVR_BAT.igs
Darwin_OP/Part Files/OP 3D CAD Files/3D IGS/9L_PR13_B_BRKT_PELV_L.igs
Darwin_OP/Part Files/OP 3D CAD Files/3D IGS/9R_PR13_B_BRKT_PELV_R.igs
Darwin_OP/Part Files/OP 3D CAD Files/3D PRT/10_FR07_H102.prt
Darwin_OP/Part Files/OP 3D CAD Files/3D PRT/11_FR07_SC101.prt
Darwin_OP/Part Files/OP 3D CAD Files/3D PRT/12_FR07_E180.prt
Darwin_OP/Part Files/OP 3D CAD Files/3D PRT/13_FR07_H120.prt
Darwin_OP/Part Files/OP 3D CAD Files/3D PRT/14_FR07_S101.prt
Darwin_OP/Part Files/OP 3D CAD Files/3D PRT/15_FR07_X102.prt
Darwin_OP/Part Files/OP 3D CAD Files/3D PRT/16_FR07_H132.prt
Darwin_OP/Part Files/OP 3D CAD Files/3D PRT/17_FR07_H133.prt
Darwin_OP/Part Files/OP 3D CAD Files/3D PRT/18_FR07_E160.prt
Darwin_OP/Part Files/OP 3D CAD Files/3D PRT/1_PR13_B01_BRKT_CAM.prt
Darwin_OP/Part Files/OP 3D CAD Files/3D PRT/2_FR07_H104.prt
Darwin_OP/Part Files/OP 3D CAD Files/3D PRT/3_FR07_X101.prt
Darwin_OP/Part Files/OP 3D CAD Files/3D PRT/4_PR13_B01_FRM_PCB_MAIN_T.prt
Darwin_OP/Part Files/OP 3D CAD Files/3D PRT/5_PR13_B01_FRM_PCB_MAIN_B.prt
Darwin_OP/Part Files/OP 3D CAD Files/3D PRT/6_PR13_B_SPACER_PELV.prt
Darwin_OP/Part Files/OP 3D CAD Files/3D PRT/7_FR07_E130.prt
Darwin_OP/Part Files/OP 3D CAD Files/3D PRT/8_PR13_FRM_CVR_BAT.prt
Darwin_OP/Part Files/OP 3D CAD Files/3D PRT/9L_PR13_B_BRKT_PELV_L.prt
Darwin_OP/Part Files/OP 3D CAD Files/3D PRT/9R_PR13_B_BRKT_PELV_R.prt
FEI/Mesmo Solido/fei.stl
FEI/Mesmo Solido/fei.stp
FEI/Sem Base/fei.stl
FEI/Solido Diferente/fei.stl
FEI/Solido Diferente/fei.stp
Milton_robot/Mechanics/Alça.ipt
Milton_robot/Mechanics/Ankle.ipt
Milton_robot/Mechanics/Arm.ipt
Milton_robot/Mechanics/Ball.ipt
Milton_robot/Mechanics/DWG Inventor/OldVersions/Alça.0002.dwg
Milton_robot/Mechanics/DWG Inventor/OldVersions/Anexo 1 - Arm.0003.dwg
Milton_robot/Mechanics/DWG Inventor/OldVersions/Anexo 10 - Right Hand.0001.dwg
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
