danilo-perico/RoboFEI-HT_Drawings/Milton_robot/Mechanics/DWG Inventor/Anexo 10 - Right Hand.pdf

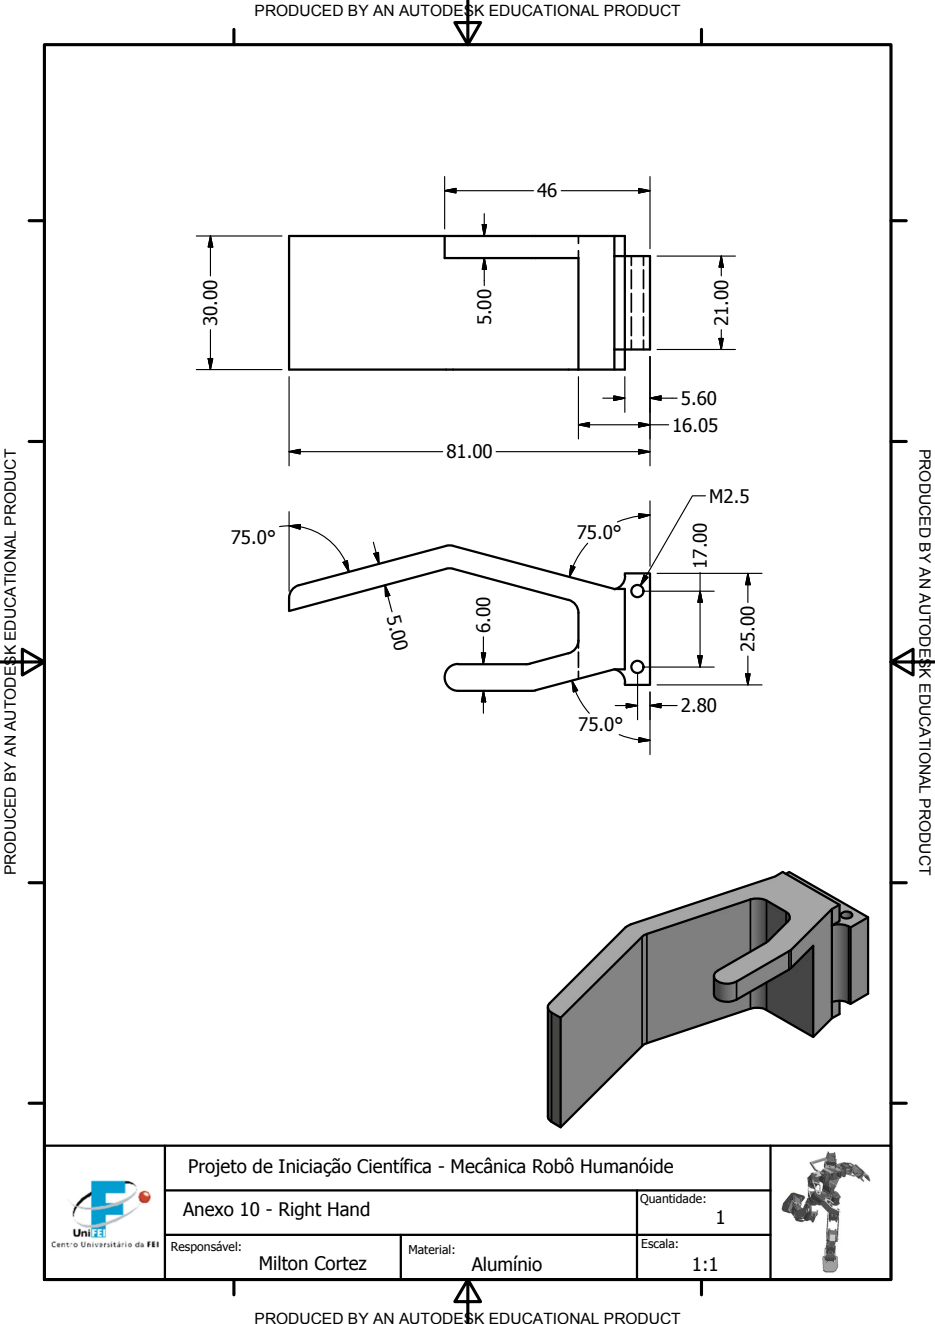
[picture p155: page 1]
TIO; A U T O D E S K E D U C A TIO; Quantidade:; Responsive; Escala: l:; Milton Cortez; Material:; Alumtnio

PRODUCED BY AN AUTODESK EDUCATIONAL PRODUCT

Projeto de Iniciaomo Cienttfica - Mecknica Rob{ Humanyide

Anexo 10 - Right Hand
