danilo-perico/RoboFEI-HT_Drawings/(commit log)

2016-03-04 add Darwin-OP files
    [10_FR07_H102.igs, 10_FR07_H102.prt, 10_FR07_H102.step, 11_FR07_SC101.igs, 11_FR07_SC101.prt, 11_FR07_SC101.step, 12_FR07_E180.igs, 12_FR07_E180.prt]
2016-03-04 add FEI drawings
    [fei.prt.step, fei.step, fei.stl, fei.stp]
2016-03-04 add Milton robot drawings
    [Alça.0002.dwg, Alça.0002.ipt, Alça.ipt, Anexo 1 - Arm.0003.dwg, Anexo 1 - Arm.dwg, Anexo 10 - Right Hand.0001.dwg, Anexo 10 - Right Hand.dwg, Anexo 11 - Neck.0003.dwg]
